bomstrong/eyebot_report/appendix01.tex

%\chapter{Source Code (Raspberry Pi)}

%\lstinputlisting[caption=main.c, language=C, label=lst_main.c]{/home/jafp/Dropbox/nfs/eyecam/main.c}
