bomstrong/eyebot_report/ch_motors.tex

\chapter{Controlling The Motors}
\label{ch:motors}

%Keywords: PWM, Encoder, H-bridge, direction control, , position controller, speed controller, straight forward controller
%duty cycle, measurements and tests, pwm frequency, h-bridge limitations
%Figures: PWM, H-bridge output (measurement), tacho (theory + measurement), schematic (section cut), direction table, 

\section {The DC-motor}

The DC-motor is an essential part of the robot. The motors used in this project are the Faulhaber 2233012S which is a 12 volt armature motor.  To succeed the tasks given in the assignment is it very important to gain control over the motor by understanding the datasheet that describes the motor. The motors dose not only supply the robot with driving force but is also the steering part of the robot.

\subsection{Gears}
To give the robot more torque a gear system has been implemented in the motors. The cost of high torque through a gear-system is a reduction in rotational speed. The gearing factor that is used is $\frac{1}{17.2}$ which means that the output shaft only turns one revolution every times the motor itself have turned 17.2 revolutions. The gear system do have some disadvantages by giving the motor nonlinearity like backlash and deadlocks. 

\subsection{Transfer function for DC-motor}
In assignment 1 from the control theory course we calculated a transfer function for at DC-motor. By using this knowledge and theory we are able to calculate a transfer function for the DC-motor used in this project.
The transfer function for the DC-motor is needed for making simulations of the hole system later on.\\
All motor data is fund in the datasheet and the weight of the robot is fund by weighting the robot on a digital precision scale and is fund to be 1400 g or 1.4 kg. \\

The general transfer function:

\begin{equation}
G(s)=\frac{\theta_m(s)}{E_a(s)} \Rightarrow \frac{\frac{k_t}{R_a J_a}}{s+\frac{1}{J_a}(D_a + \frac{K_bK_t}{R_a})}
\end{equation}
  
 The transfer function for the robot: 

\begin{equation}
G(s)=\frac{\omega(s)}{E_a(s)}=\frac{\frac{1633}{23.43}}{s\frac{1}{23.43} +1} = \frac{69.69}{0.04268+1}
\end{equation}  

Where $0.04268$ is the time constant. \\
The step respons on the DC-motor looks like this:

\begin{figure}[!h]
	\centering
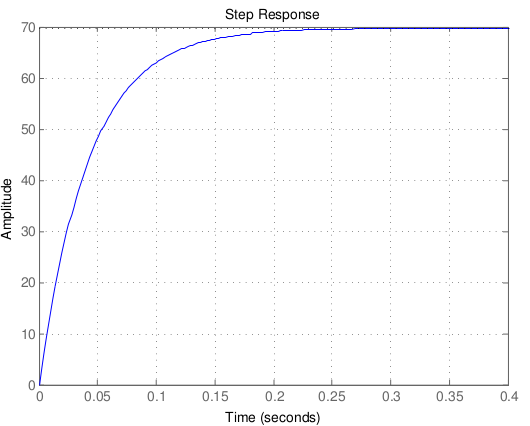
[picture p14: resources/motor_transfer_function.png]
	
	\caption{Step respons for DC-motor}
	\label{fig:2}
\end{figure}

\section{Microcontroller} 
The MCU (Microcontroller) is the first part of the link between the sensor input and the DC-motor. In the MCU a translation is made so that the DC-motor can be controlled using simple I2C (Two wire communication) commands from the Raspberry pi. A controller is also implemented in the MCU so that the robot is able to run straight without any further instructions from the Raspberry pi.\\

The MCU decodes the command form the Raspberry pi and then extracts informations about direction and speed. These informations is then send down to a H-bridge and ends as Voltage in the DC-motor.

\subsection{Atmel's XMEGA series}
The MUC used in the robot is an Atmel ATxmega192c3 a 8bit low-power microcontroller with 192kbyte flash memory running a clock frequency at 32 MHz. The choice of this MCU is based on the its speed performance and its high level of functionality features. The first MCU used in this project was a Atmel Atmega 32 but after a brief discussion in the group and with the project supervisor we decided to change the MCU to a more modern model. We previously worked with the Atmega32 and wanted to explore more recent technologies and the opportunity to work with the SMD (surface mounted device) method. 

\subsection{Programming and tools}
The MUC is programed using Atmel studio 6.1 and the program language used is C. The ASF (Atmel Software Framework, \citep{asf}) libraries has be used to a great extent.  \\
The source code for the MCU can be found in the appendix. 

\section{H-bridge as driver}
The H-bridge (TI293DNE) is a well known easy to use device. The devise have been used for robotics for many years and is well documented. \\  
The H-bridge receive three lines per motor (six in total) from the MCU the first line controls the speed with a PWM signal and the to other lines control the rotational direction of the motor. The output from the H-bridge is connected directly to the two DC-motors.

\subsection{PWM - Pulse Width Modulation}

PWM (Pules-width modulation) is a frequently used method in electronics. The signals intensity it controlled by changing the duty cycle for a square wave signal with a predefined frequency. The controllable range is from 0$\% $ to 100$\%$ 
The frequency of the square has been chosen to be 20kHz so that is it over the human hearing range. 
\\
The figures below shows how a 25$\%$ and a 50$\%$  PWM looks between the MCU and the H-bridge. The duty cycle output of the MCU is about 15 $\%$ and 82$\%$ The reason for that is that the controller in the MCU manipulates the PWM, more about this in the Control System chapter.

\begin{figure}[!h]
	\centering
	\subfloat[PWM with input at 25$\%$] {
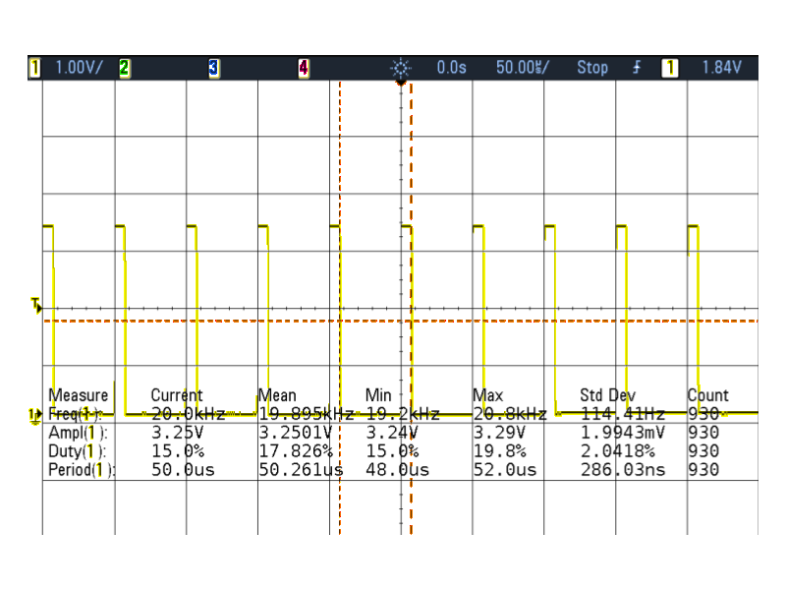
[picture p15: resources/Scop/PWM_motot_right_PWMin25.png]
		
		%\caption{PWM with input at 25$\%$}
		\label{fig:1}
	}
	\subfloat[PWM with input at 50$\%$] {
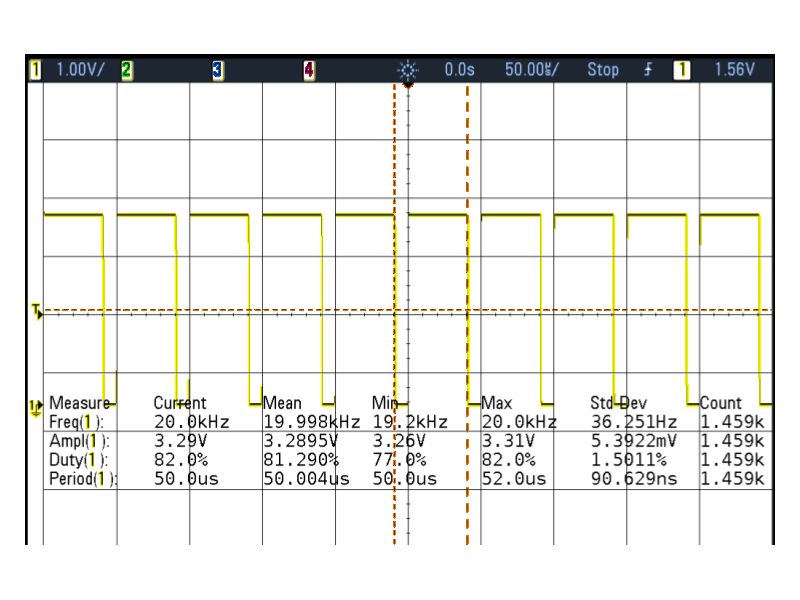
[picture p16: resources/Scop/PWM_motot_right_PWMin50.png]
		
		%\caption{PWM with input at 50$\%$}
		\label{fig:2}
	}
\end{figure}

\subsection{Direction control} 
To control the rotational direction of the DC-motor the H-bridge receives two lines A1 and A2 from the MCU.

When line A1 is high and line A2 is low the corresponding switches S1 and S4 is closed so that the current is running in one direction. when A1 is low and A2 is high the current is running the other way and the motor it turning the other way around. \\
  \begin{figure}[!h!]
	\centering
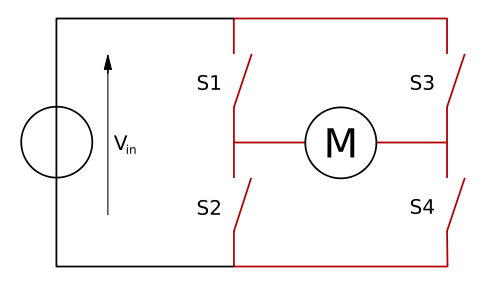
[picture p17: resources/H-bridge_diagram.png]
	
	\caption{H-bridge}
	\label{fig:3}
\end{figure}

  \begin{figure}[!h!]
	\centering
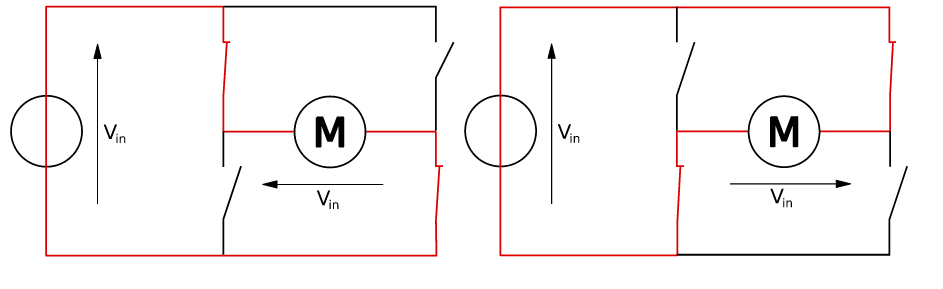
[picture p18: resources/h_bridge_2.png]
	
	\caption{H-bridge in the two states}
	\label{fig:3}
\end{figure}

In figure 3.6 is a truth table that describes the functionality of the H-bridge. The EN pin is the PWM input.  

  \begin{figure}[!h!]
	\centering
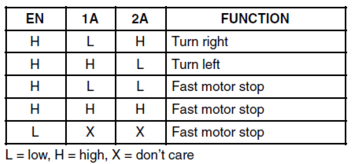
[picture p19: resources/H-bridge_table.png]
	
	\caption{H-bridge truth table}
	\label{fig:intro_4}
\end{figure}

\section{Encoders}
  The DC-motor includes two encoder outputs which is used to determine position, velocity and direction of the DC-motor.
  Each encoder outputs 15 pulses per round and after the gears is the resolution $15 \cdot 17.2 = 258$ pulses per round.
  The two encoder signals is phase shifted at about $\ang{90}$ and that gives us the opportunity to determine the rotational direction of the motor by looking at one encoder signal and then check if the other one it high or low. This method is illustrated below in figure 3.7.
   
  \begin{figure}[!h!]
	\centering
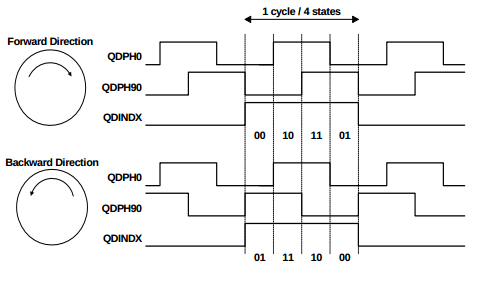
[picture p20: resources/encoder_atmel.png]
	
	\caption{Encoder illustration (from Atmel's Application Note on Quadrature Decoders, \citep{avr1600})}
	\label{fig:5}
\end{figure}

Figure 3.8 shows the actual encoder output from the robot. The phase is about $\ang{100}$ between the two encoders.
  \begin{figure}[!h!]
	\centering
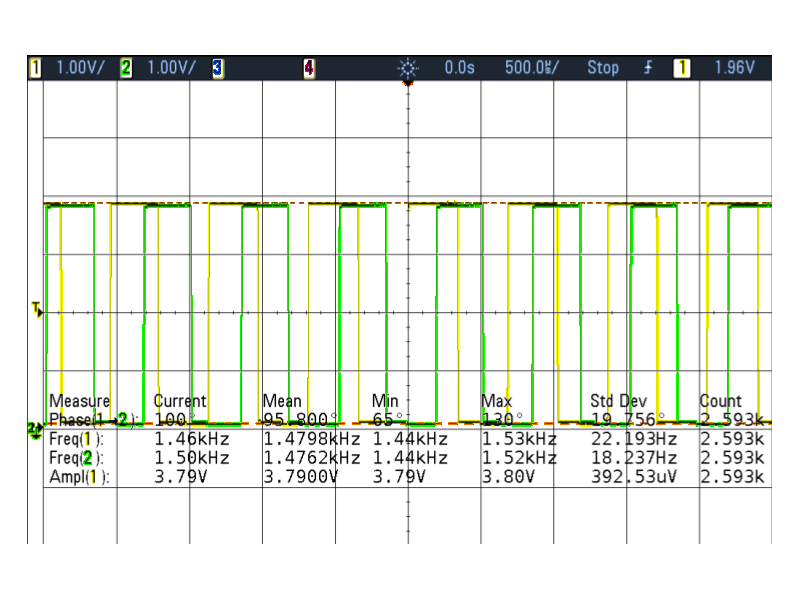
[picture p21: resources/Scop/encoder.png]
	
	\caption{Encoder output from Motor to MCU}
	\label{fig:6}
\end{figure}
%-----------------------------------------------------_SKAL RETTES _-----------------------------------------
The velocity is found by sampling the encoder pulses over a time period of 10ms, by counting the pulses during this time and multiply it with a constant the velocity of the motor is given.
Also the position between the two motors can be find by using two encoders on each motor. First we look at one motor encoder count and then match this up the other motor so that the encoder count from the to motors fits, then we know the exact position of the robot. We use these method in the position controller.    
%skal rettes---------------------------------------------------------------------------------------------------

\section{Feedback and Control Loop}
The control loop containing the motor,MCU and encoder can be described as a unity feedback loop.

  \begin{figure}[!h!]
	\centering
	
	\caption{Unity feedback loop}
	\label{fig:6}
\end{figure}

The MCU have three different stats with three different controllers so that it can adapt to the given situation during the track. The three states are:

\begin{itemize}
	\begin{item}
		\textbf{Straight}\\ This state is designed to make the robot go straight without any corrections from the Raspberry Pi. This it done by given both motors a reference speed and then aligning them after the outputs from the encoders by adjusting the speed to each motor. 
	\end{item}
	
	\begin{item}
		\textbf{Position}\\This state is used when the robot has to do precision maneuvers. 
	\end{item}
	
	\begin{item}
		\textbf{Speed}\\This state is used when the robot follows the line by adjusting after instruction from the Raspberry Pi.
	\end{item}

\end{itemize}

The selection of which current stat the MCU should be in is determinant by the raspberry pi and is set through the I$^2$C bus.
The different controllers from the three states can be found in the control system chapter.
