bomstrong/eyebot_report/eyebot_jp.tex

% Master Thesis DTU Template
% Remus M. Prunescu remusmp@gmail.com Feb, 2011

\documentclass[a4paper,11pt]{memoir}

% Include all settings
\input{setup}

\begin{document}

\input{titlePage}
\input{images}

\frontmatter
\tableofcontents
\cleardoublepage
\listoffigures
\printnomenclature

\mainmatter

\input{ch_intro}
\input{ch_camera}
\input{ch_motors}
\input{ch_wall_dist}
\input{ch_communication}
\input{ch_controller}
\input{ch_track}
\input{ch_simu}
\input{ch_conclusion}

\appendix
%\appendixpage

\input{appendix01}
%\input{appendix02}
%\input{appendix03}

\backmatter

\bibliography{references}
\bibliographystyle{plainnat}

% For biblatex
%\printbibliography
%\printindex

\end{document}
