bomstrong/eyebot_report/titlePage.tex

\begin{titlingpage}
 \thispagestyle{empty}
 \enlargethispage{1.3cm}
 \calccentering{\unitlength}
 \begin{adjustwidth}{\unitlength}{-\unitlength}
 %\begin{raggedleft}
  \vspace*{-1.9cm}
  %\hspace{8cm}\includegraphics[width=0.5\textwidth]{resources/tex_dtu_uk_a1_cmyk}\\[1cm]
  \begin{textblock}{6.5}(5.5,0) %
   
  \end{textblock}
 %\end{raggedleft}
  \begin{raggedright}
   \vspace{\stretch{1}}
   %\vspace{1cm}
   {\Huge\sffamily\ThAuthors\\[2cm]}
   \begin{Spacing}{1.2}
    {\sffamily\HUGE\textbf{\ThTitleEN}\\[1.5cm]}
    %{\sffamily\LARGE\textbf{{\ThSubtitleEN}}\\[1cm]}
    {\sffamily\LARGE{4th Semester Project in Control Theory}\\[2cm]}
   \end{Spacing}
   \vspace{\stretch{1}}
   %\begin{Spacing}{1.5}
   %{\Large Supervisors:\\}
   %{\Large\ThSupervisors\\}
   %\end{Spacing}
   %\vspace{\stretch{3}}   
   %{\sffamily DTU - Technical University of Denmark, Kgs. Lyngby - 2011}\\[1cm]
   %\vspace{\stretch{4}}
 \end{raggedright}
 %\begin{raggedright}
 %  \includegraphics[width=0.5\textwidth]{resources/tex_dtu_elektro_a_uk}%
 %  \ifthenelse{\equal{\bCompanyLogo}{true}}{%
 %   \begin{textblock}{3}(9.5,-0.85) %
 %    \includegraphics[width=\textwidth]{resources/CompanyLogo}
 %   \end{textblock}
 %  }{} % End if
 %\end{raggedright}

 \end{adjustwidth}
 
 \clearpage
 
 %\thispagestyle{empty}
 %\enlargethispage{1.3cm}
 %\calccentering{\unitlength}
 %\begin{adjustwidth}{\unitlength-0.4cm}{-\unitlength-0.4cm}
 %\begin{raggedleft}
 % %\vspace*{-2.5cm}
 % %\includegraphics[width=0.5\textwidth]{resources/tex_dtu_uk_a1_cmyk}\\[1cm]
 %%\end{raggedleft}
 % \begin{center}
 %  \vspace{\stretch{1}}
 %  %{\sffamily\Huge Author:}\\
 %  \vspace{1.5cm}
 %  {\Huge\scshape\ThAuthors}\\[2cm]
 %  \begin{Spacing}{3}
 %   {\sffamily\HUGE\textbf{\ThTitleEN}}\\[1cm]
 %   {\sffamily\LARGE\textbf{{\ThSubtitleEN}}}\\[1cm]
 %  %{\sffamily\LARGE\textbf{\color{red}CONFIDENTIAL\\BURN AFTER READING}}\\
 %  %\vspace{\stretch{3}}
 %   {\sffamily\LARGE{Master's Thesis, September 2011}}\\[2cm]
 %  \end{Spacing}
 %  \vspace{\stretch{2}}
 %  \begin{Spacing}{1.5}
 %  {\Large Supervisors:}\\
 %  {\Large\ThSupervisors\\}
 %  \end{Spacing}
 %  \vspace{\stretch{3}}   
 %  {\sffamily DTU - Technical University of Denmark, Kgs. Lyngby - 2011}\\[1cm]
 %  \vspace{\stretch{4}}
 %\end{center}
 %\begin{raggedright}
   %\includegraphics[width=1.4cm]{resources/DTULogo.pdf}\\[1cm]
   %{\raggedright\includegraphics[width=0.5\textwidth]{resources/tex_dtu_elektro_a_uk}}
 %\end{raggedright}
  
 %\end{adjustwidth}
 
 %\cleardoublepage
 
\thispagestyle{empty}
 \calccentering{\unitlength}
 \begin{adjustwidth*}{\unitlength}{-\unitlength}
  %\vspace{\stretch{1}}
  %\textbf{\ThTitleEN, \ThSubtitleEN}\\
  \textbf{\ThTitleEN}
  %\textbf{\ThTitleDK, \ThSubtitleDK}
  \vspace{\stretch{1}}

  \noindent\textbf{This report was prepared by:}\\
  \ThAuthors
  
  \vspace{\stretch{2}}

  \noindent\textbf{Advisors:}\\
  \ThSupervisors
  
  \vspace{\stretch{3}}

  \noindent\ThDepartment
  
  \vspace{\stretch{4}}
  
  \noindent\ThElektroEmail
  
  \vspace{\stretch{5}}
  
  \noindent{\renewcommand{\arraystretch}{2}\begin{tabular}{@{}lp{0.75\textwidth}}
   Project period:&	\ThProjectPeriod\\
   ECTS:&		\ThECTS\\
   Education:&		\ThEducation\\
   Field:&		\ThField\\
   %Class:&		\ThClass\\
   %Remarks:&		\ThRemarks\\
   Copyrights:&		\ThCopyrights
  \end{tabular}}

  %\vspace{\stretch{2}}
  %\begin{center}
  % \includegraphics[width=0.8\textwidth]{resources/tex_dtu_frise.pdf}
  %\end{center}
 \end{adjustwidth*}
\end{titlingpage}
