bomstrong/eyebot_report/images.tex

  

\begin{figure}
	\centering
	\subfloat {
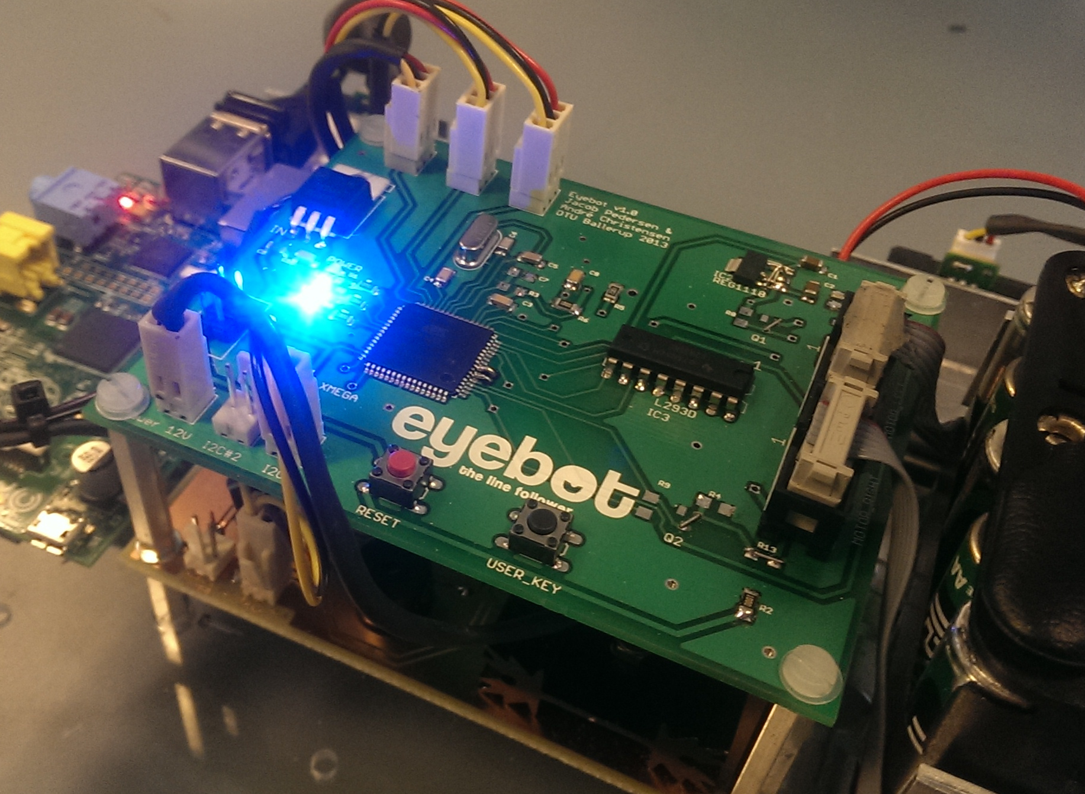
[picture p42: resources/eyebot.jpg]
		
	}
	\subfloat {
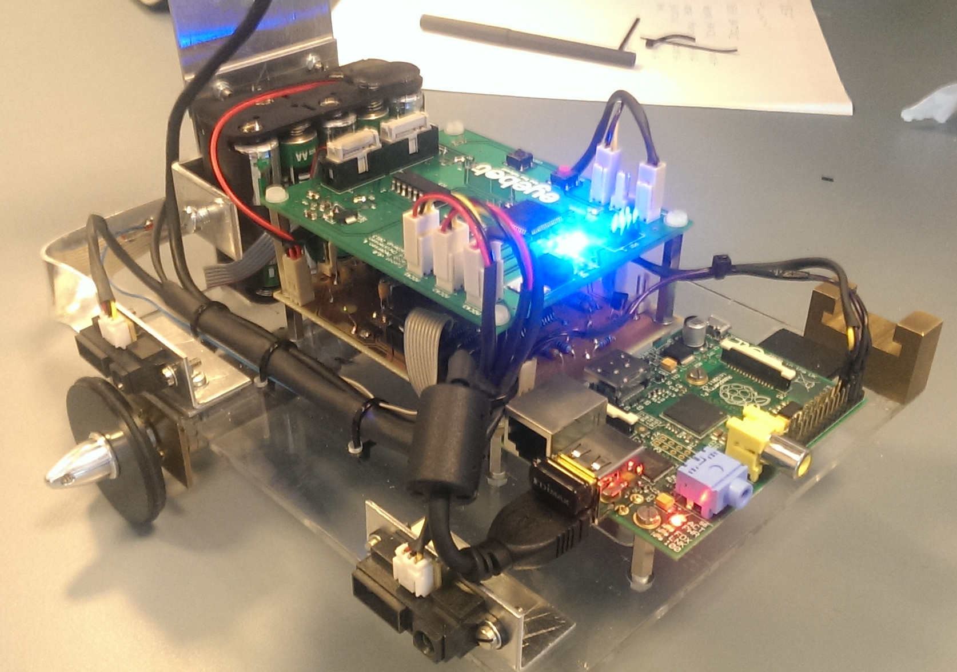
[picture p43: resources/eyebot2.jpg]
		
	}
\end{figure}

\begin{figure}
	\centering
	\subfloat {
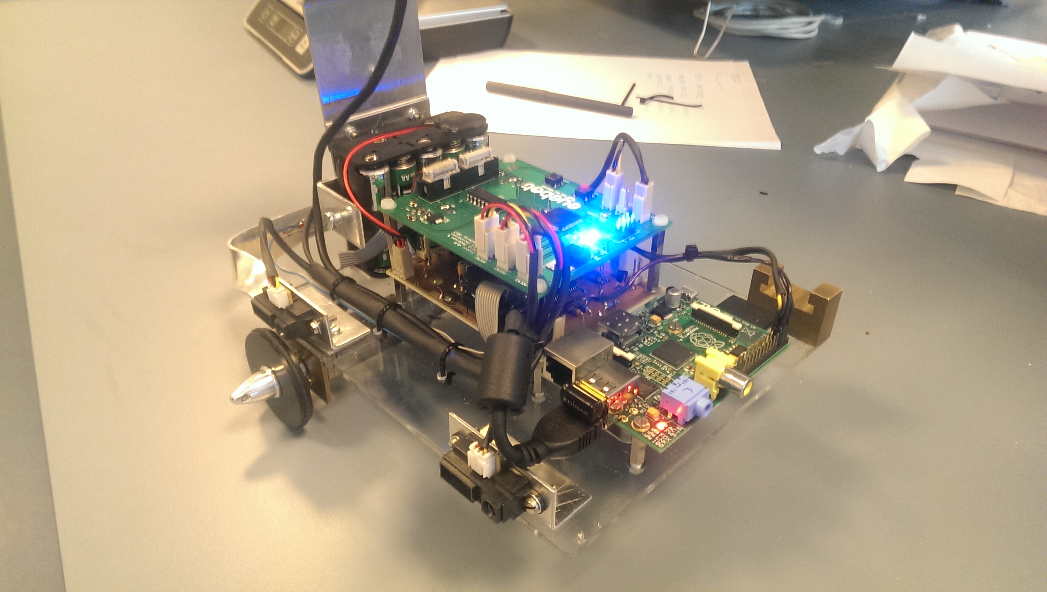
[picture p44: resources/eyebot3.jpg]
		
	}
	\subfloat {
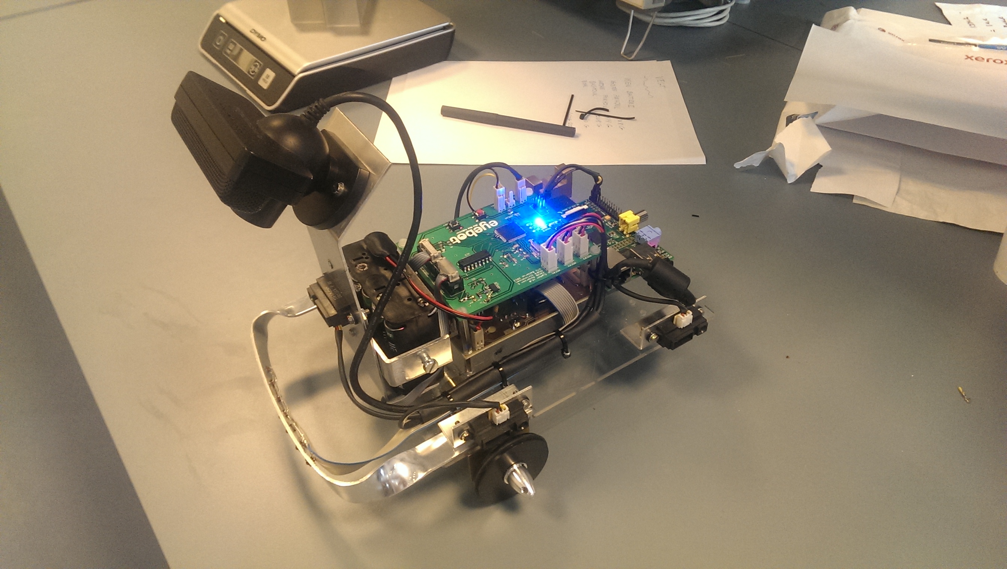
[picture p45: resources/eyebot4.jpg]
		
	}
\end{figure}

\begin{figure}
	\centering
	\subfloat {
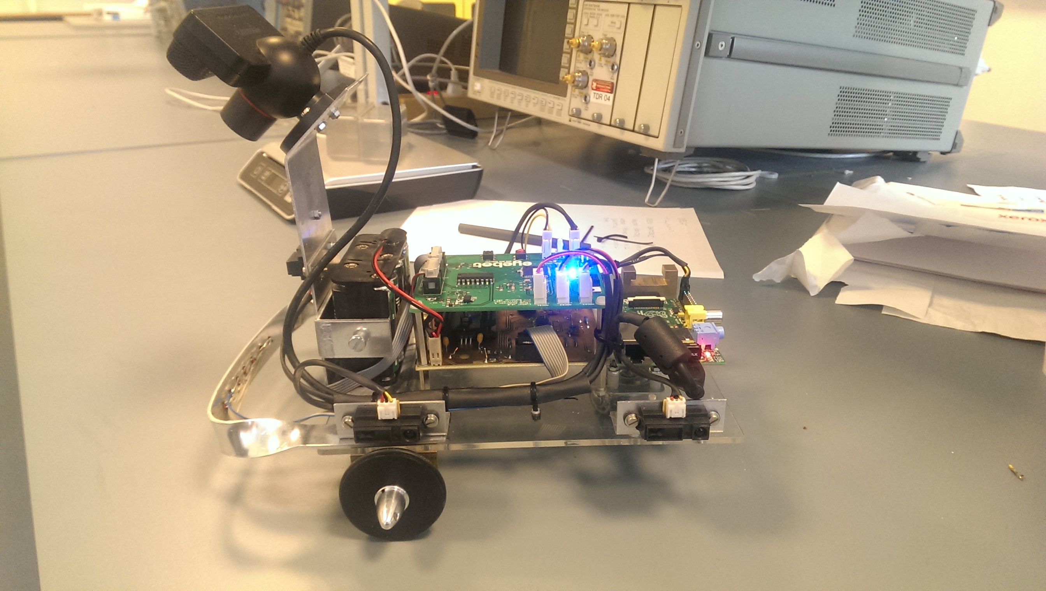
[picture p46: resources/eyebot5.jpg]
		
	}
	\subfloat {
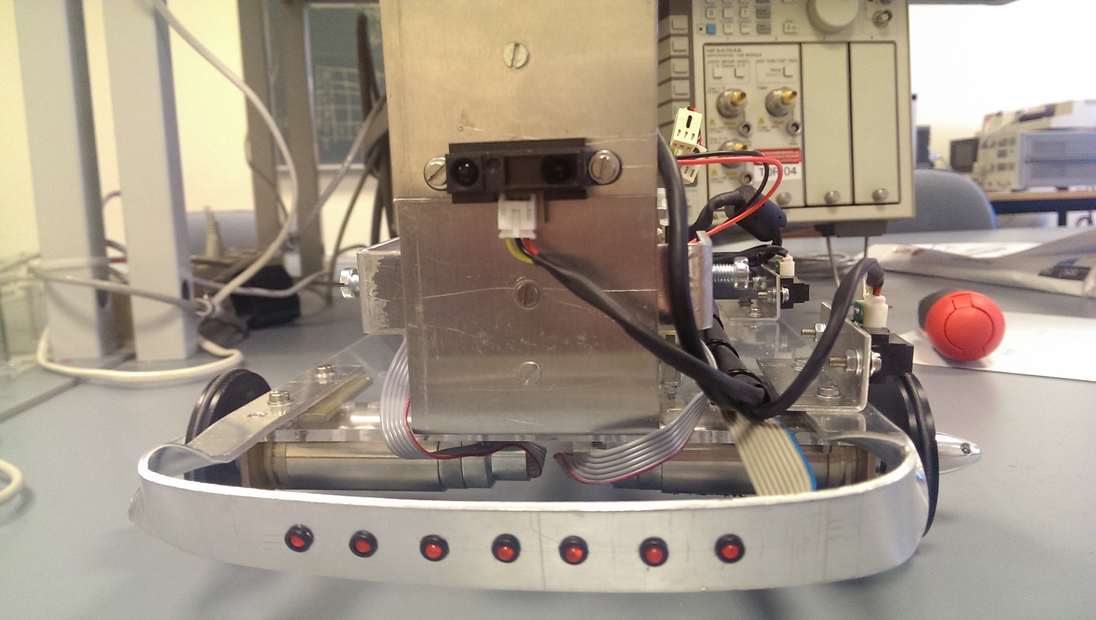
[picture p47: resources/eyebot6.jpg]
		
	}
\end{figure}

\begin{figure}
	\centering
	\subfloat {
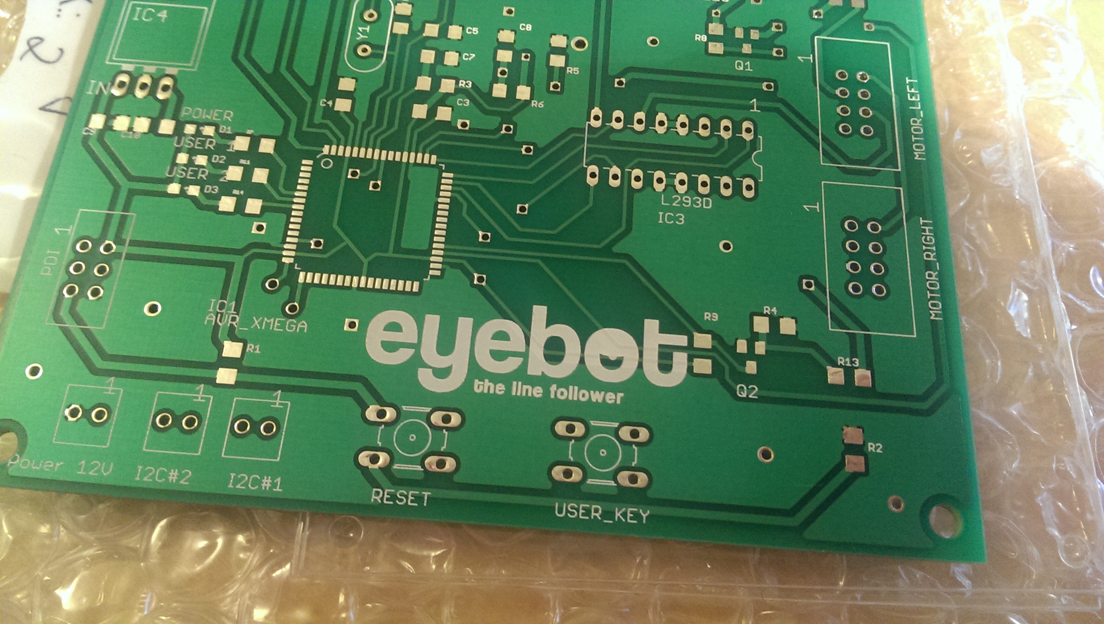
[picture p48: resources/eyebot7.jpg]
		
	}
	\subfloat {
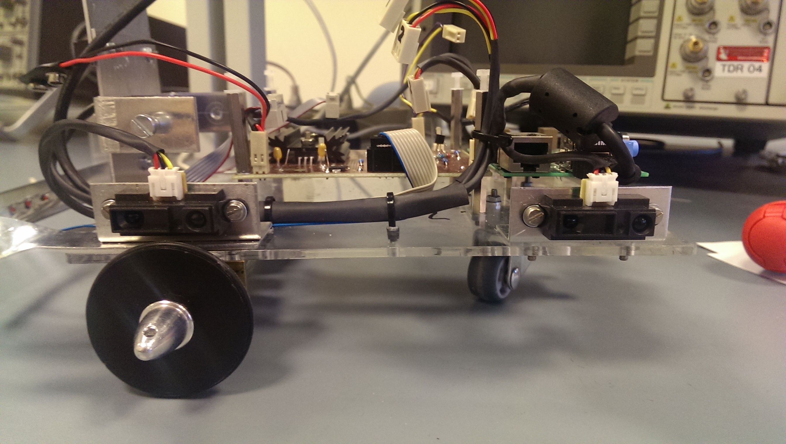
[picture p49: resources/eyebot8.jpg]
		
	}
\end{figure}
