bomstrong/eyebot_report/resources/Scop/encoder_motor_left_PWM_afterPID_14.pdf

12/12/13 | LXI - Agilent - DSO7014A - MY49110205

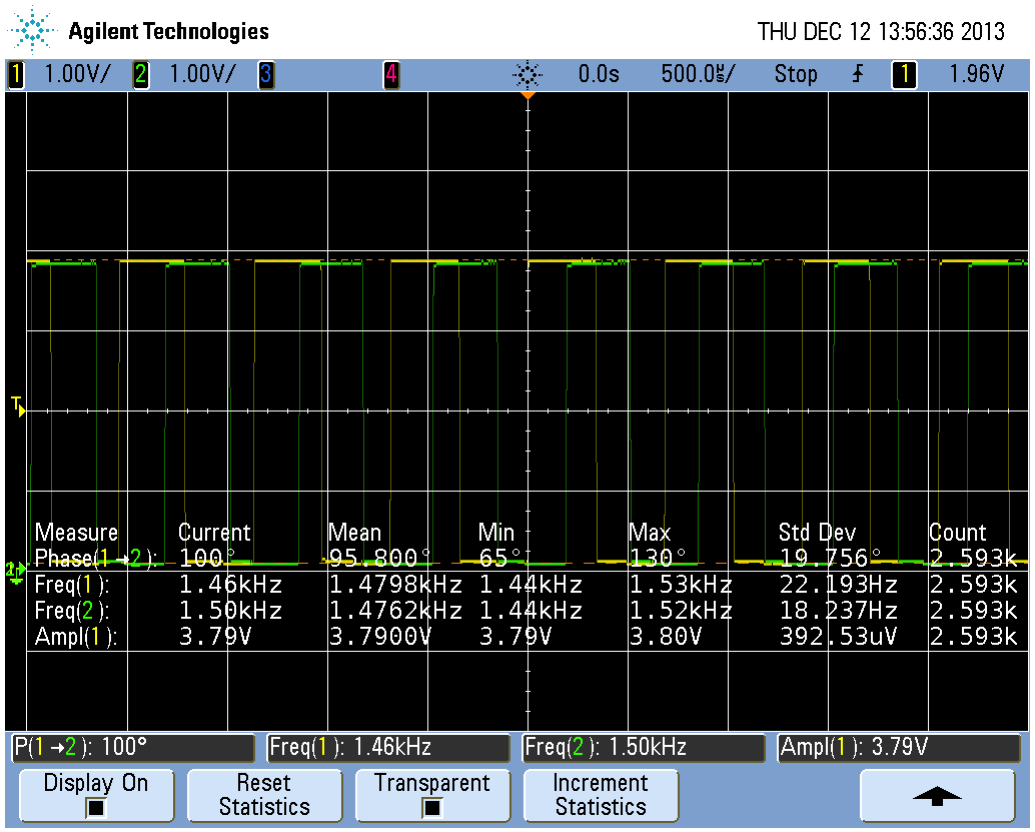
[picture p50: figure]

10.42.0.17 | 1/1

Instrument screen image uploaded 12/12/2013 2:18:25 PM
