bomstrong/eyebot_report/resources/Scop/PWM_motot_left_PWMin25.pdf

12/12/13 | LXI - Agilent - DSO7014A - MY49110205

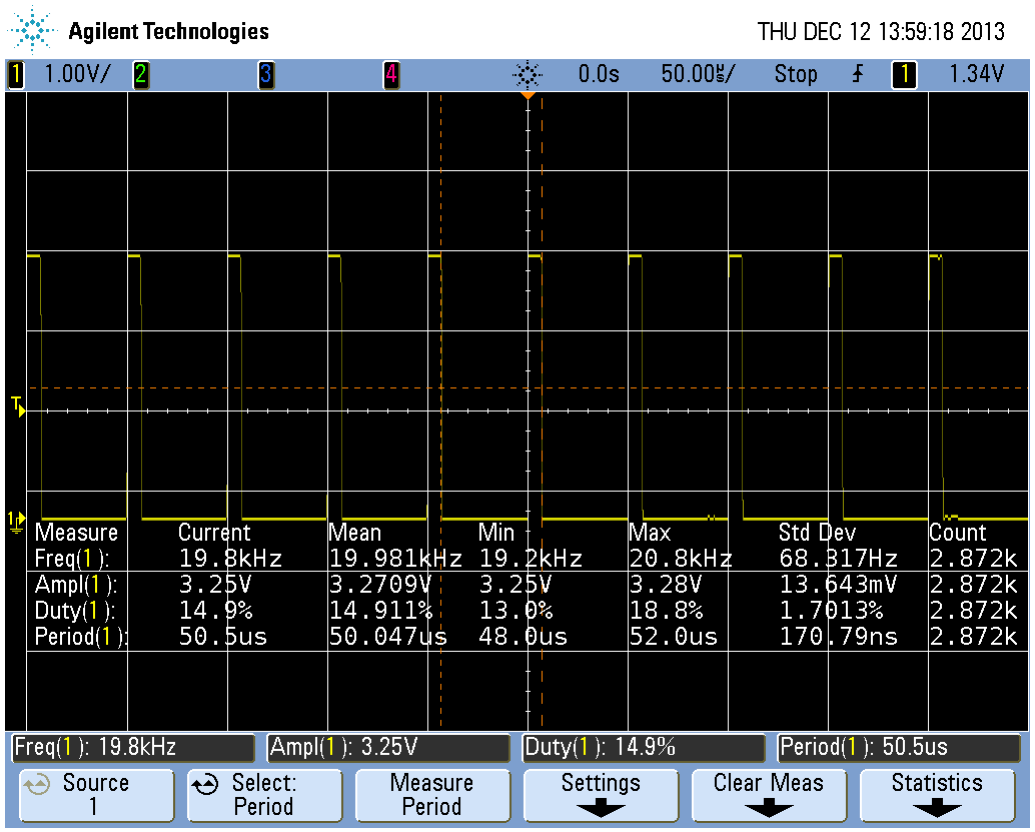
[picture p53: figure]

10.42.0.17 | 1/1

Instrument screen image uploaded 12/12/2013 2:21:07 PM
