bomstrong/eyebot_report/resources/hist-zoom.png

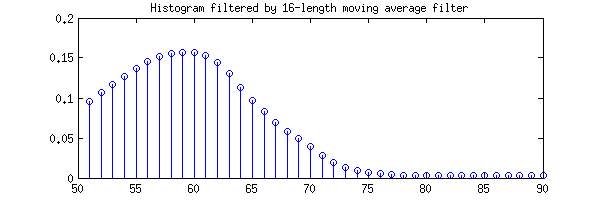
resources/hist-zoom.png
