bomstrong/eyebot_report/resources/img-raw-captures.png

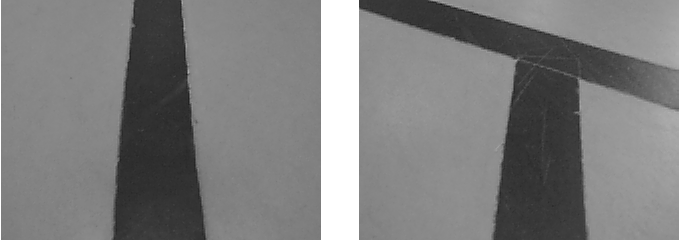
resources/img-raw-captures.png
