bomstrong/eyebot_report/resources/PCB/xmeag_motorcontroller_after_updates/PCB1.png

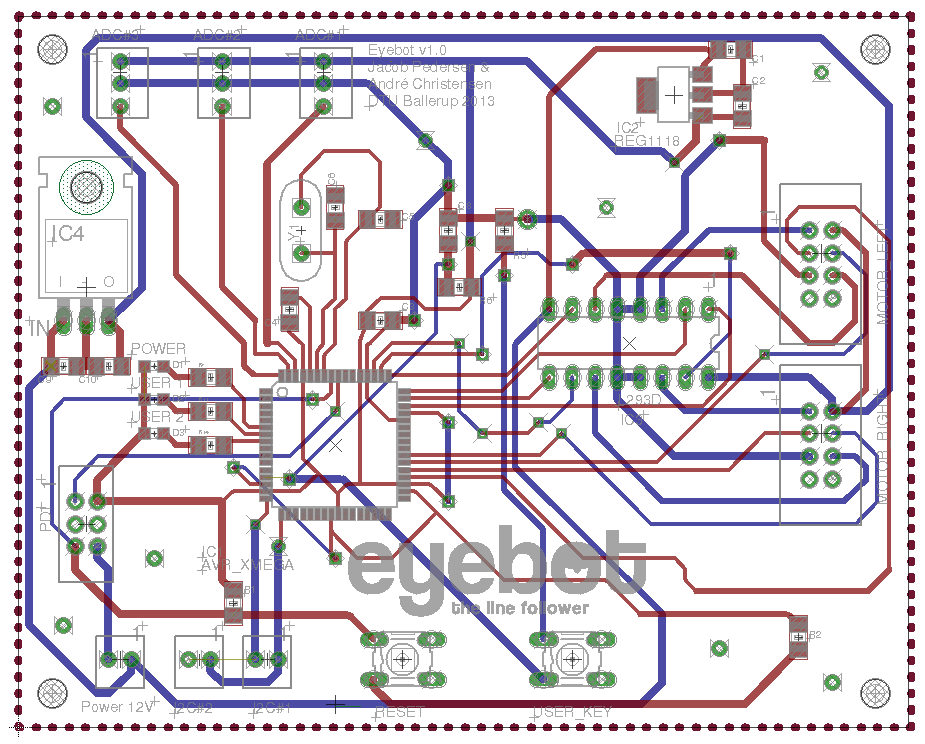
resources/PCB/xmeag_motorcontroller_after_updates/PCB1.png
