bomstrong/eyebot_report/resources/Simulink/ch_simu_2.png

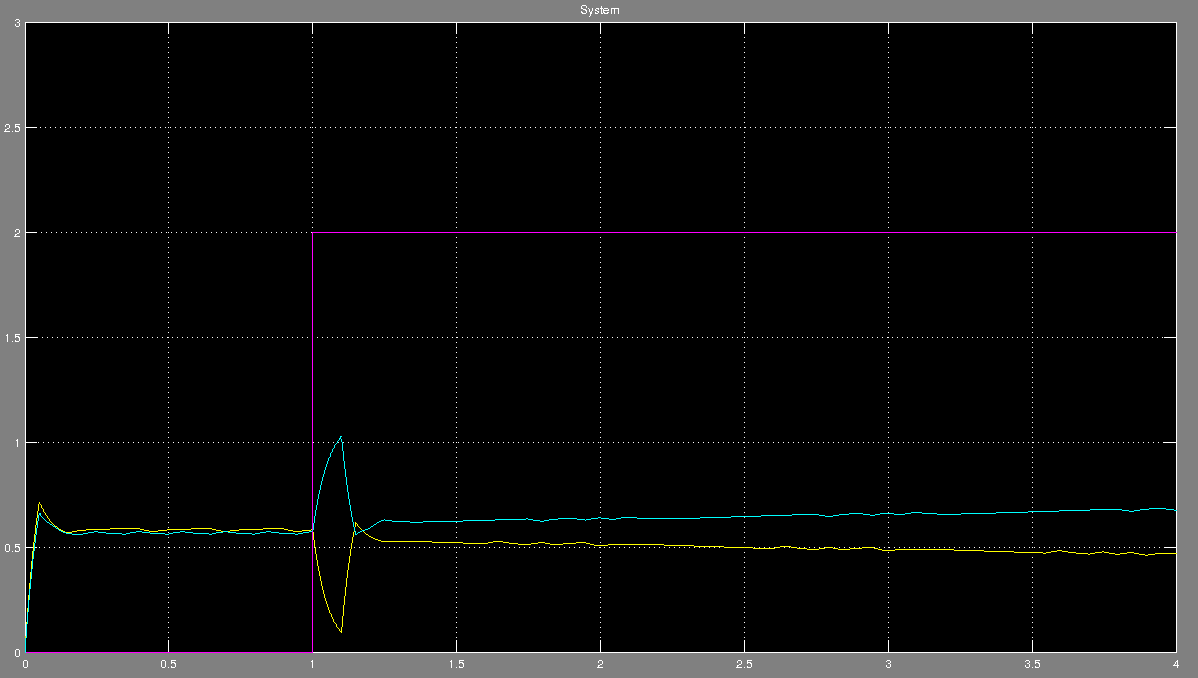
resources/Simulink/ch_simu_2.png
