bomstrong/eyebot_report/resources/Simulink/ch_simu_10.png

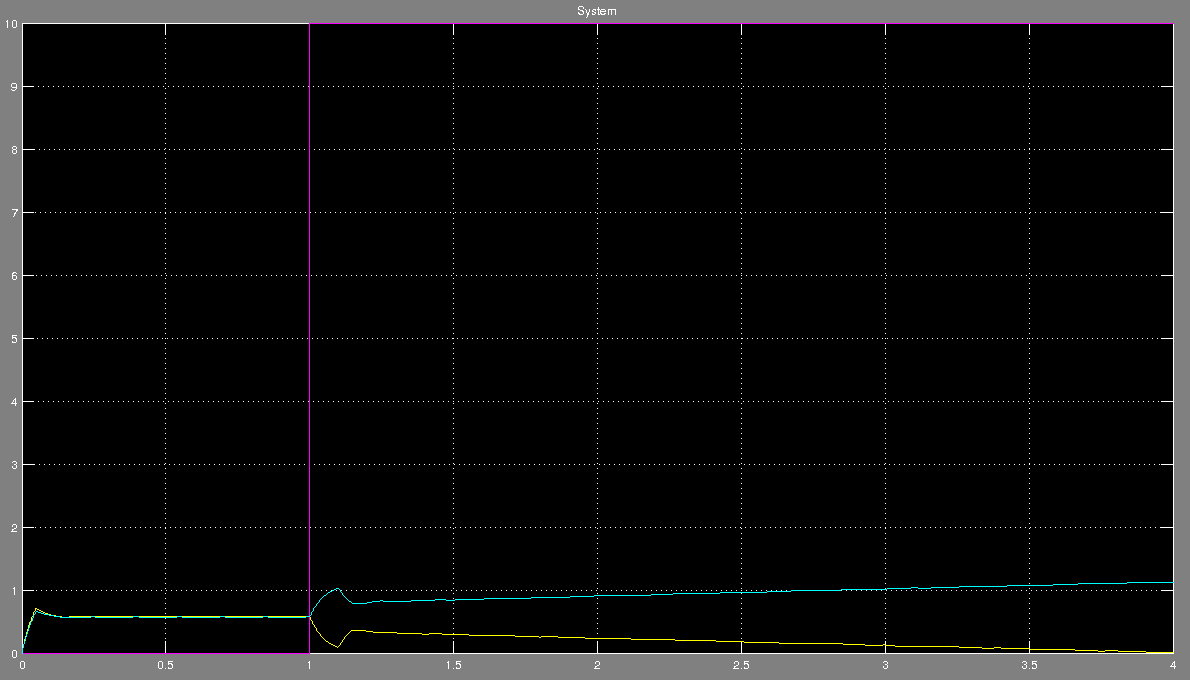
resources/Simulink/ch_simu_10.png
