bomstrong/eyebot_report/resources/Simulink/ch_simu_simulink.png

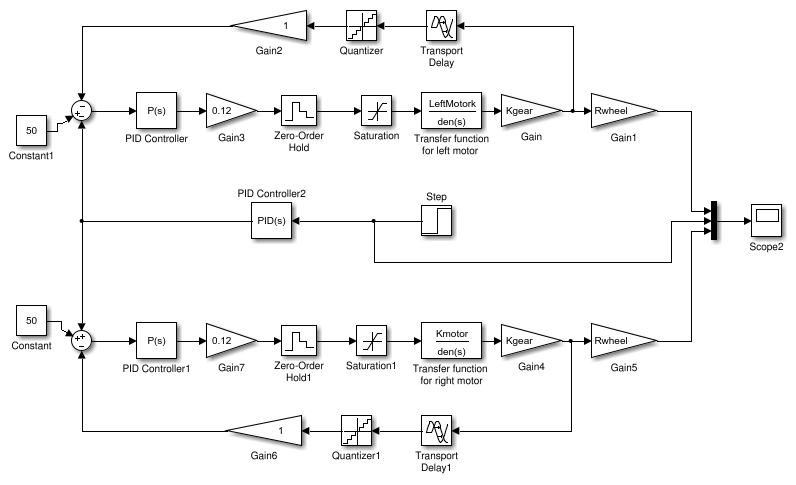
resources/Simulink/ch_simu_simulink.png
