bomstrong/eyebot_report/resources/wall_sensor.png

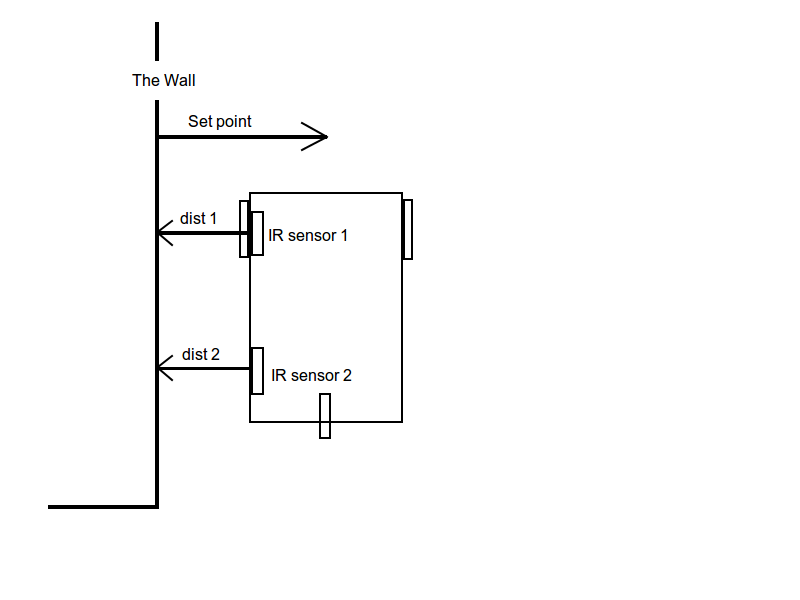
resources/wall_sensor.png
