bomstrong/eyebot_report/resources/PCB/PDF to print/Motorcontroller_sch.pdf

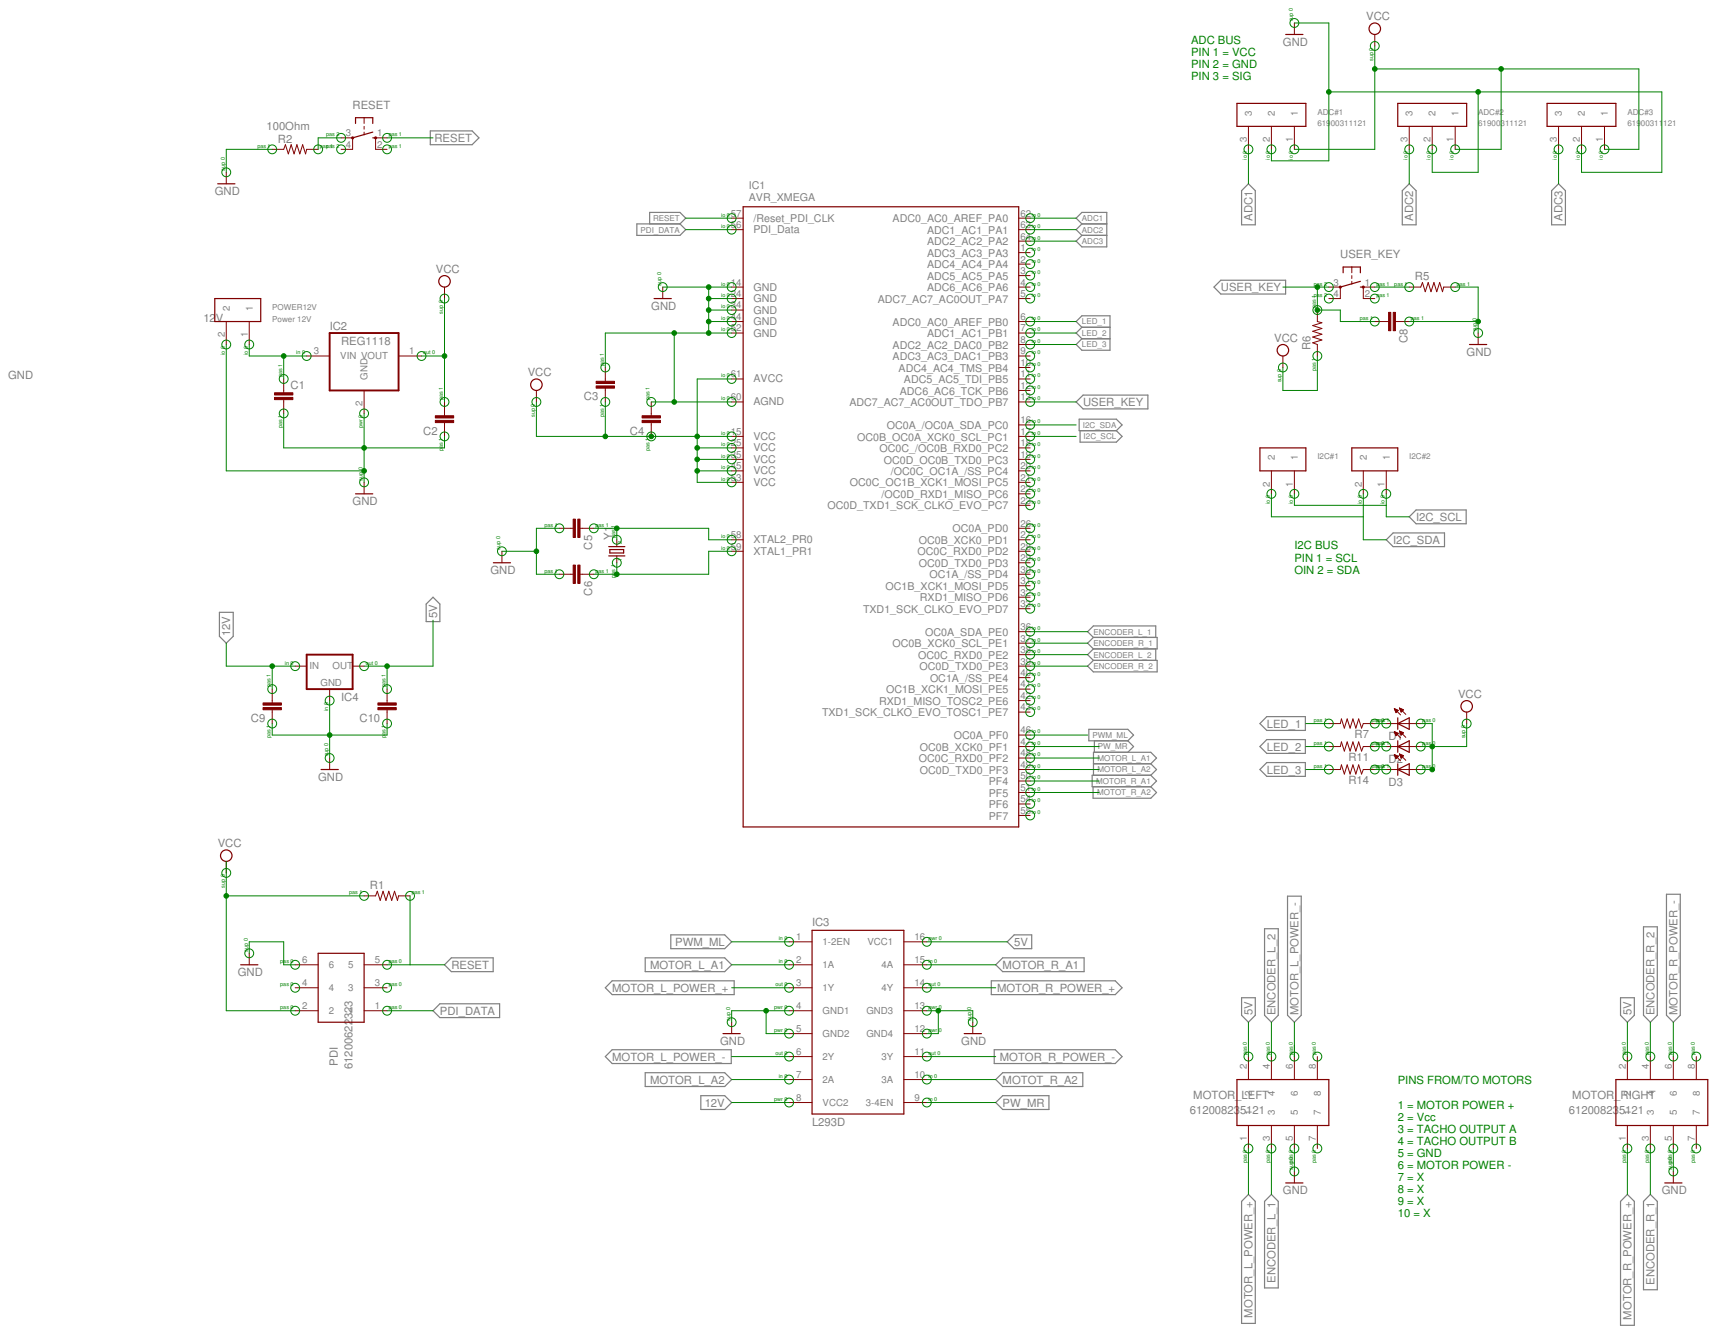
[picture p65: page 1]

35 io 0 | 19
io 0 45 | 20
53 io 0 | 21

PINS FROM/TO MOTORS
1 = MOTOR POWER +
2 = Vcc 3 = TACHO OUTPUT A
4 = TACHO OUTPUT B
