bomstrong/eyebot_report/resources/PCB/PDF to print/Motorcontroller.pdf

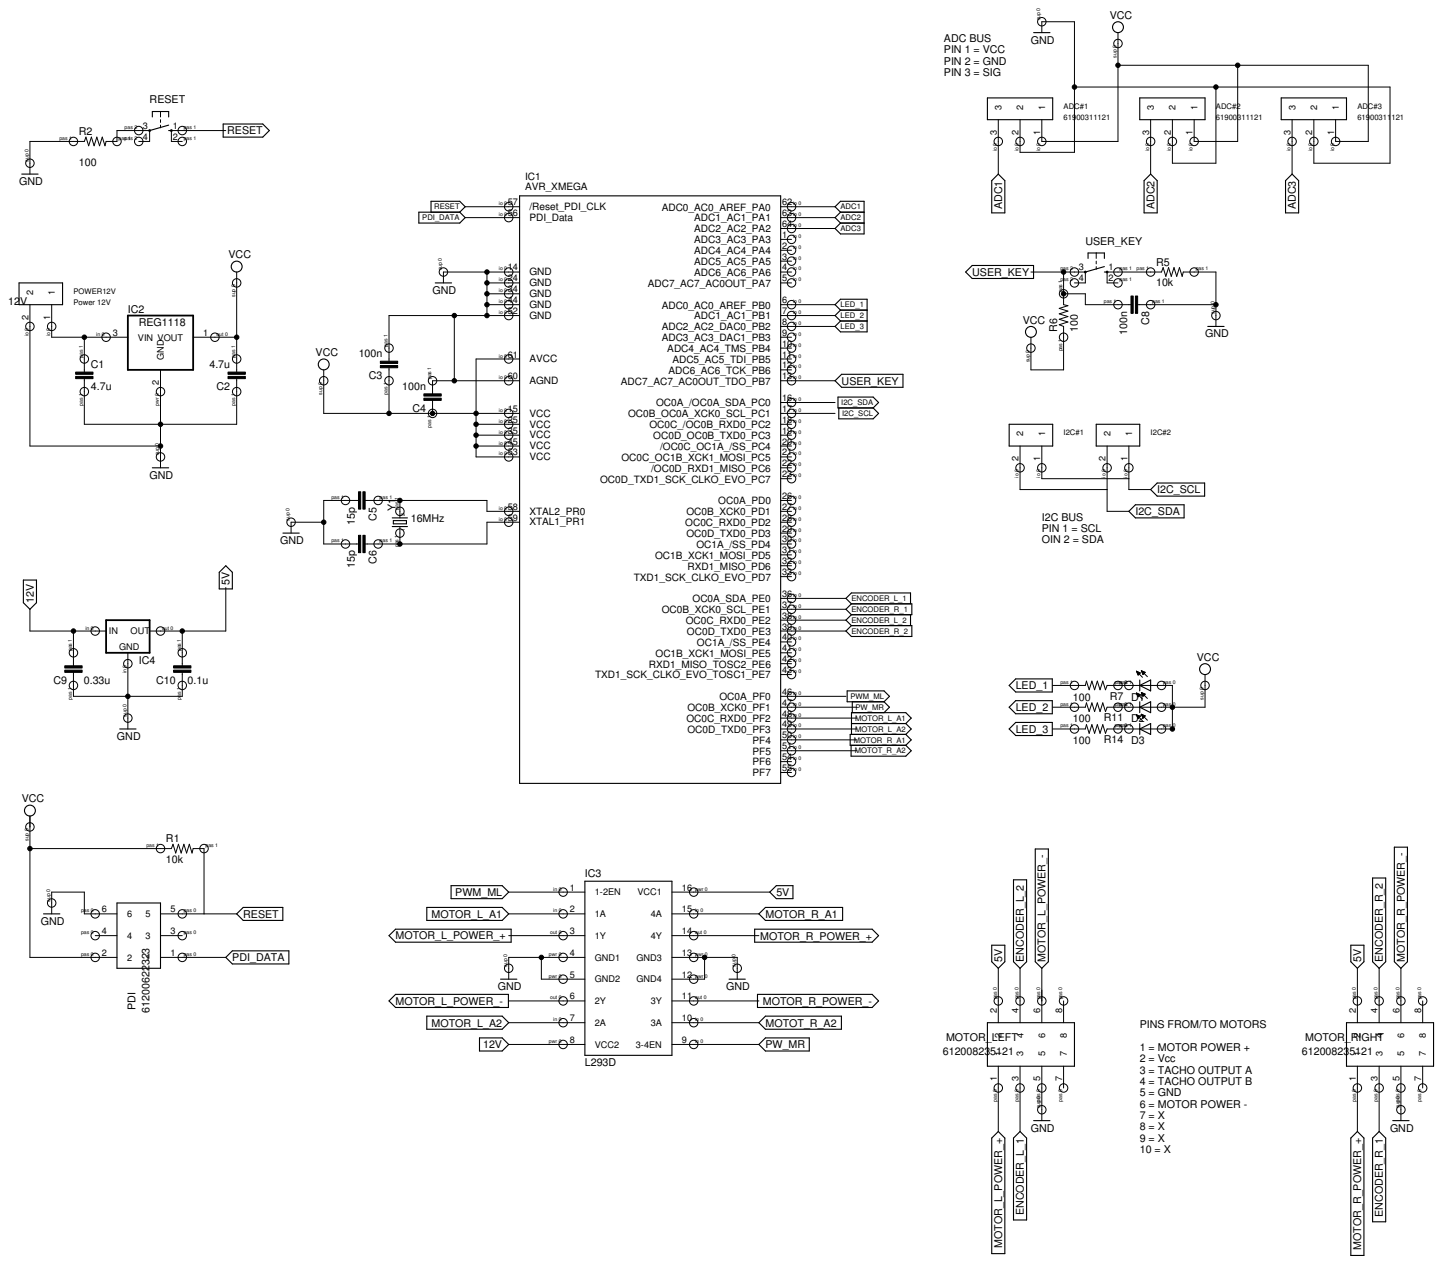
[picture p66: page 1]

25 io 0 | 18
io 0 35 | 19
45 io 0 | 20
53 io 0 | 21

PINS FROM/TO MOTORS
1 = MOTOR POWER +
2 = Vcc 3 = TACHO OUTPUT A
4 = TACHO OUTPUT B
5 = GND
