bomstrong/eyebot_report/resources/PCB/Eyebot_powerdist/Eyebot_powerdist.pdf

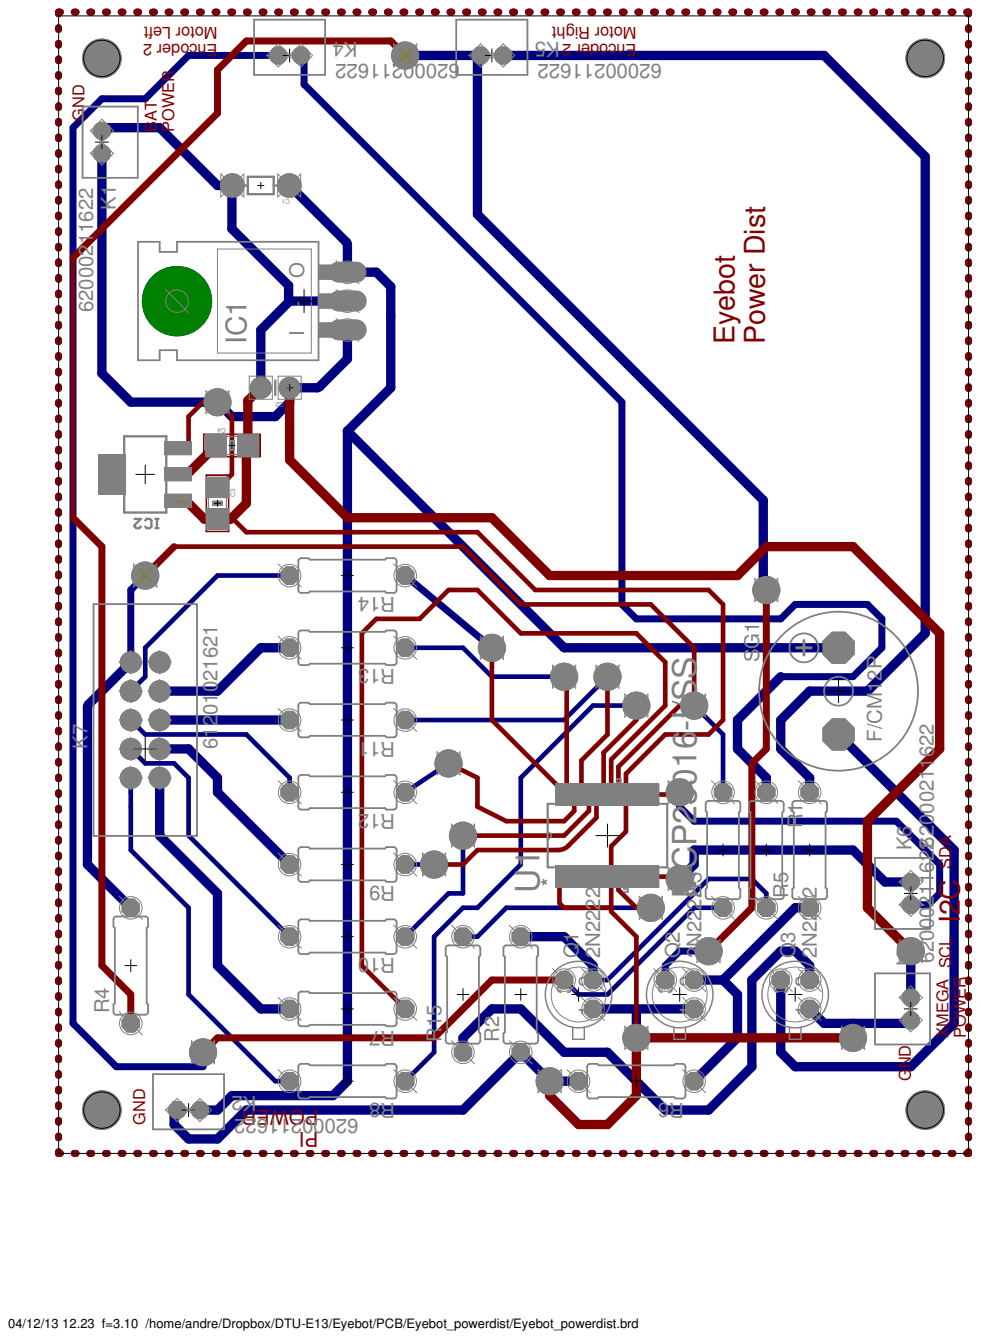
[picture p67: page 1]

04/12/13 12.23 f=3.10 /home/andre/Dropbox/DTU-E13/Eyebot/PCB/Eyebot_powerdist/Eyebot_powerdist.brd
