bomstrong/eyebot_report/resources/PCB/Eyebot_powerdist/Eyebot_powerdist_with_full_layer.pdf

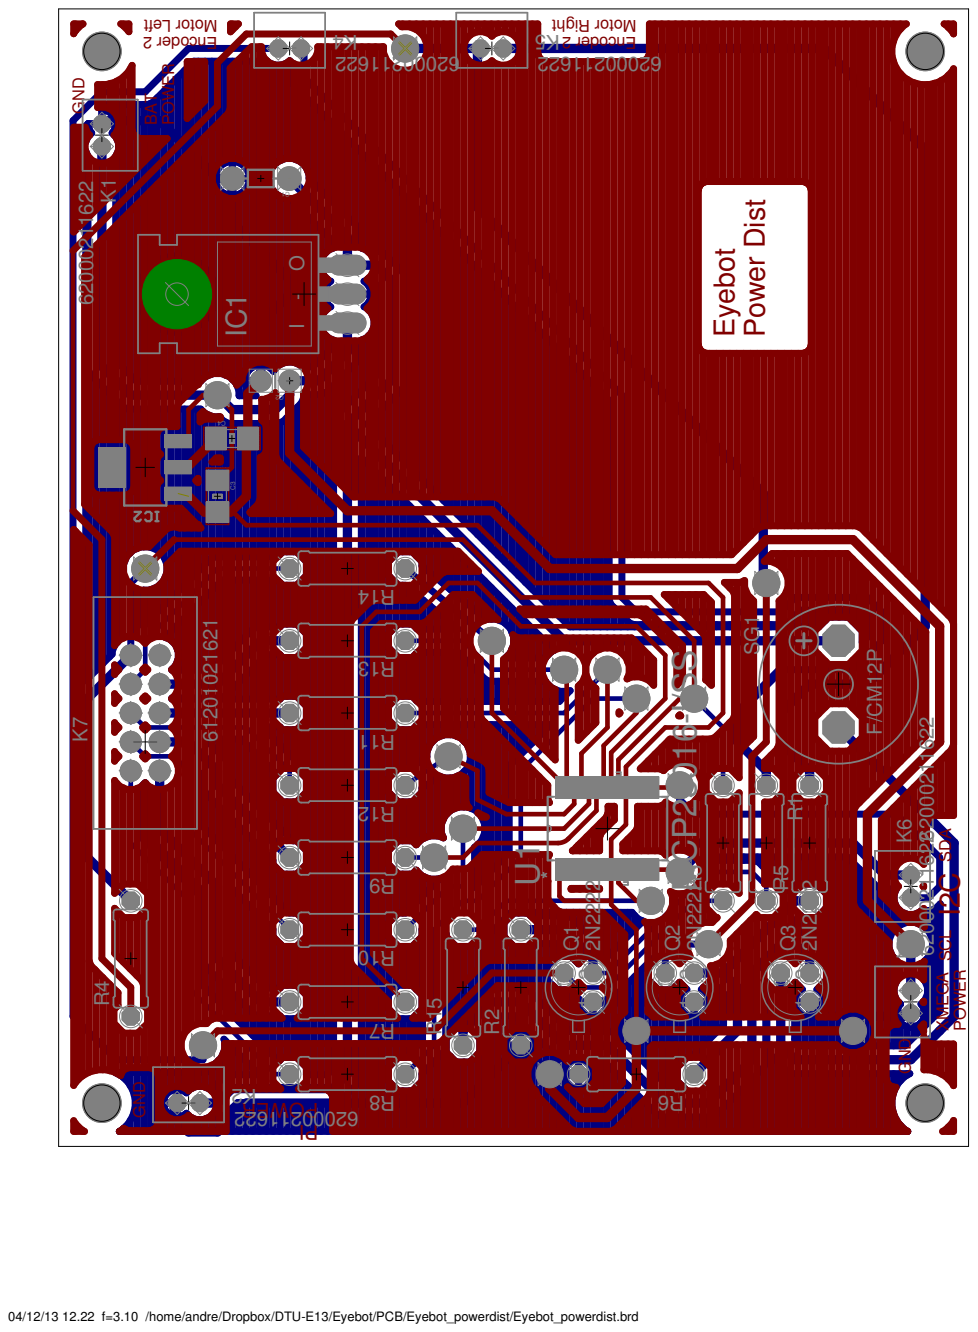
[picture p68: page 1]

04/12/13 12.22 f=3.10 /home/andre/Dropbox/DTU-E13/Eyebot/PCB/Eyebot_powerdist/Eyebot_powerdist.brd
