bomstrong/eyebot_report/resources/PCB/xmeag_motorcontroller_after_updates/Motorcontroller_pcb.pdf

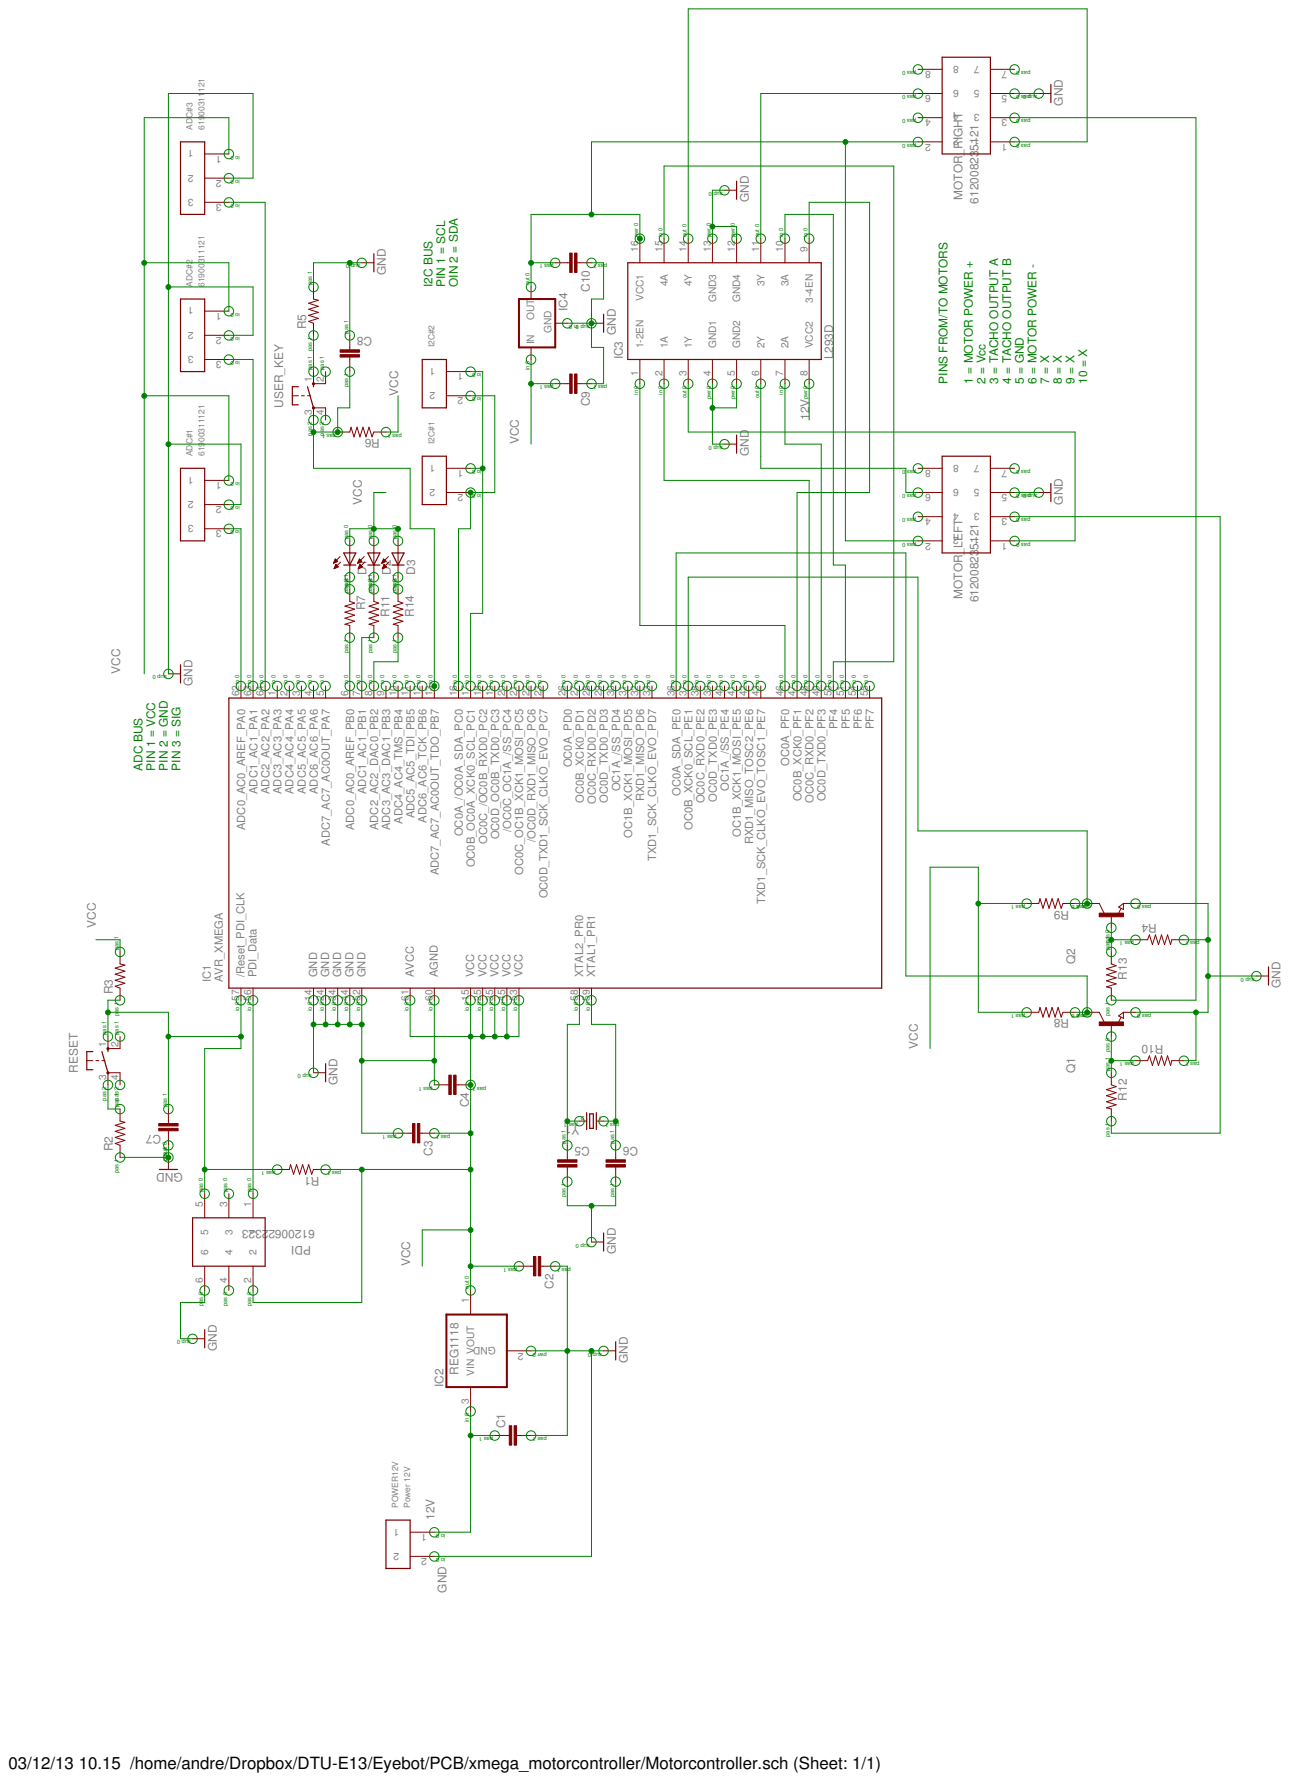
[picture p69: page 1]

PIN 1 = SCL OIN 2 = SDA

/Reset_PDI_CLK GND GND GND GND GND

pas 1 pas 1

03/12/13 10.15 /home/andre/Dropbox/DTU-E13/Eyebot/PCB/xmega_motorcontroller/Motorcontroller.sch (Sheet: 1/1)
