bomstrong/eyebot_report/resources/PCB/xmeag_motorcontroller_after_updates/Motorcontroller_sh.pdf

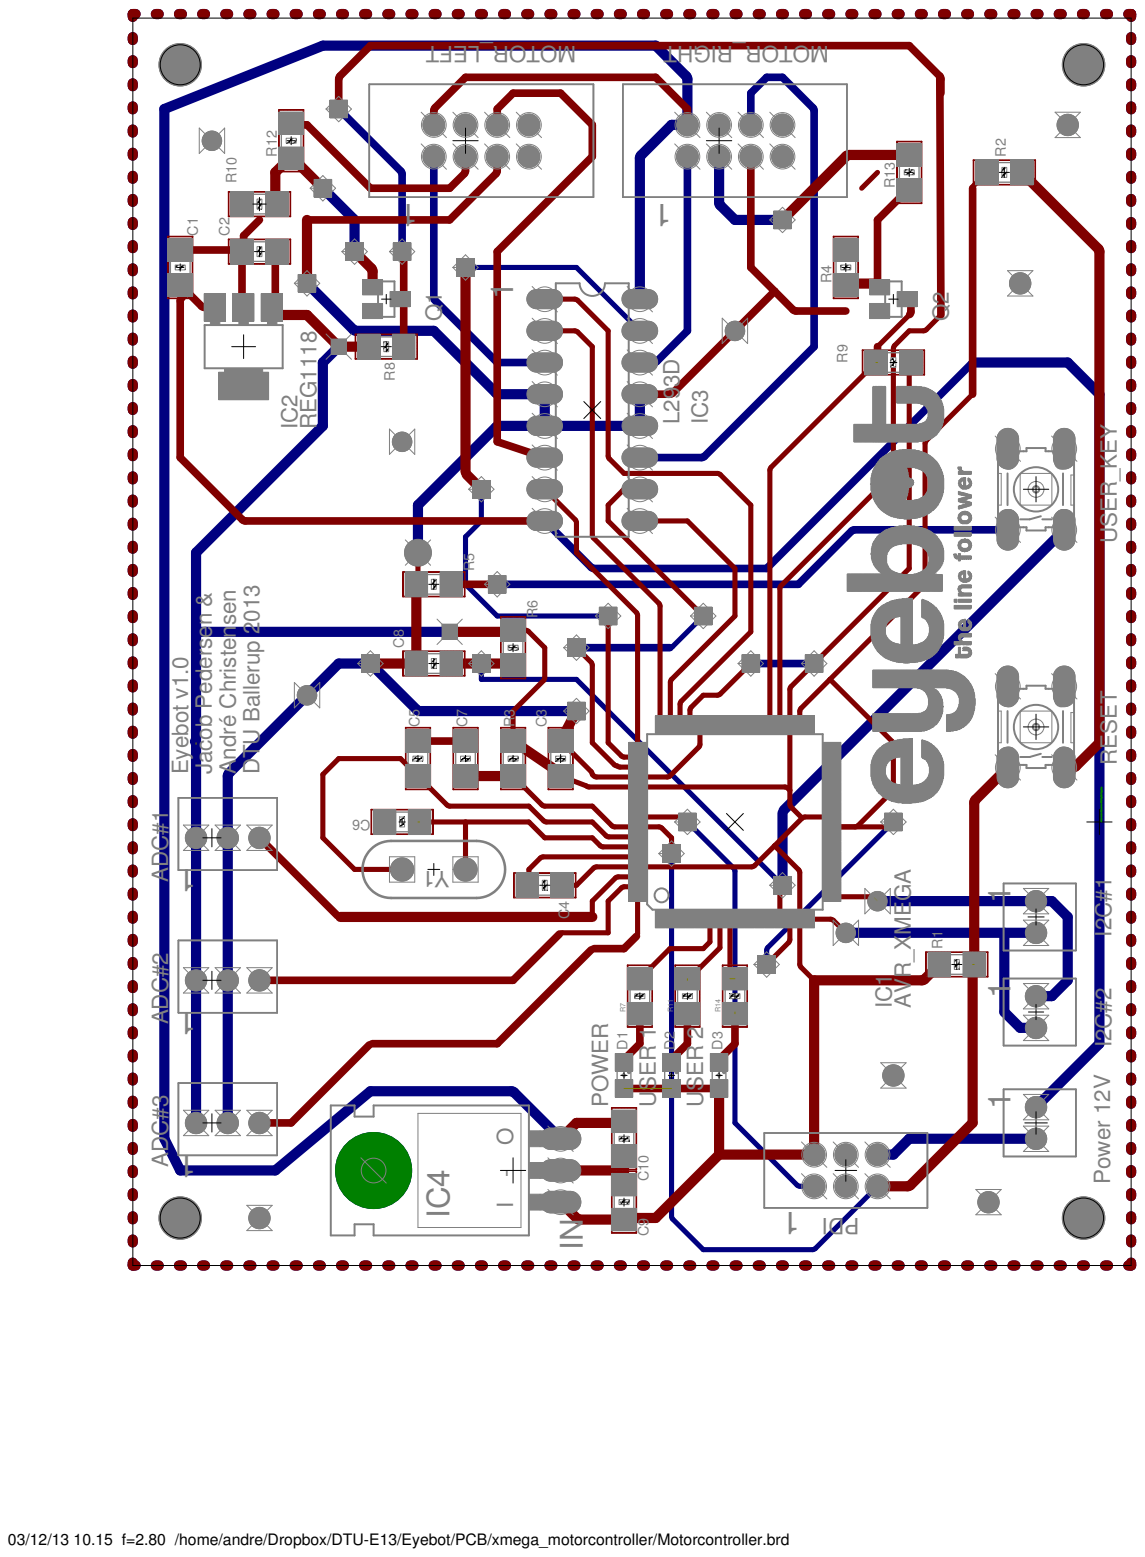
[picture p70: page 1]

03/12/13 10.15 f=2.80 /home/andre/Dropbox/DTU-E13/Eyebot/PCB/xmega_motorcontroller/Motorcontroller.brd
