bomstrong/eyebot_report/resources/PCB/PDF to print/Motorcontroller_pcb_1.pdf

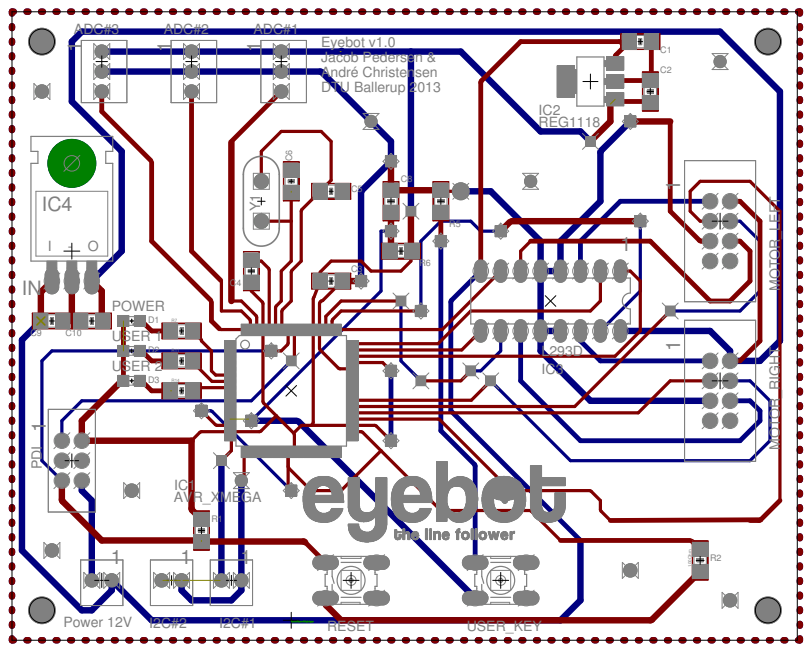
[picture p71: page 1]
