bomstrong/eyebot_report/resources/PCB/PDF to print/Motorcontroller_pcb_2.pdf

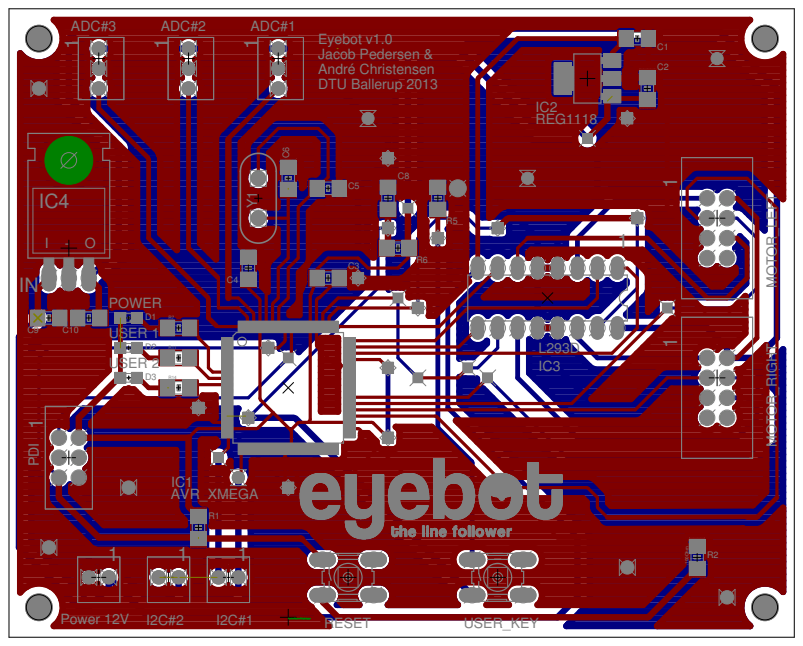
[picture p72: page 1]
