bomstrong/eyebot_report/resources/PCB/PDF to print/power_dist_pcb_1.pdf

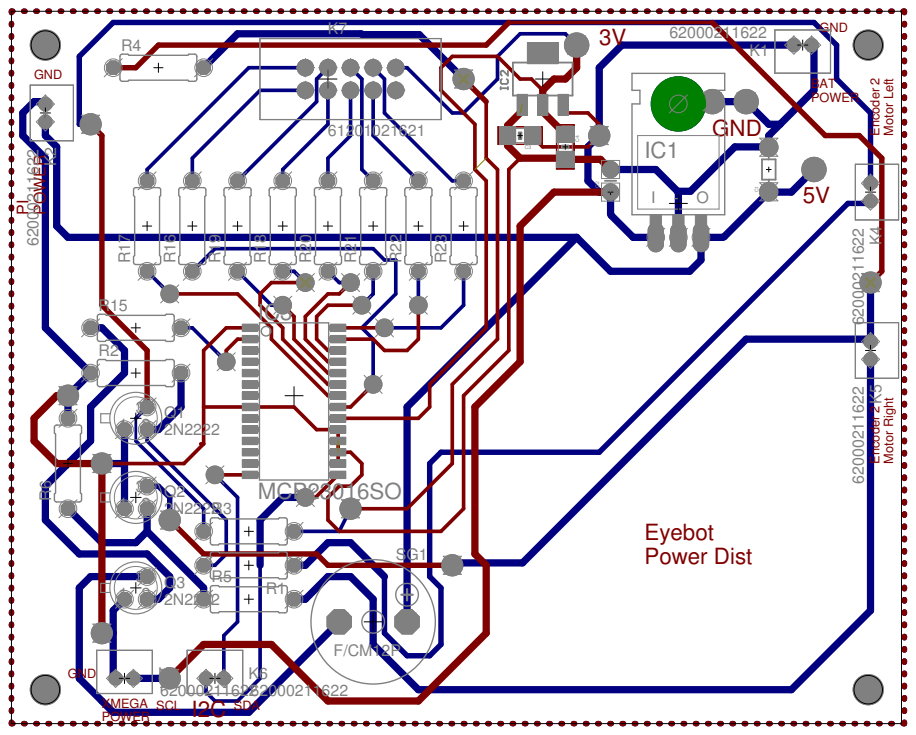
[picture p73: page 1]
