bomstrong/eyebot_report/resources/PCB/PDF to print/power_dist_pcb_2.pdf

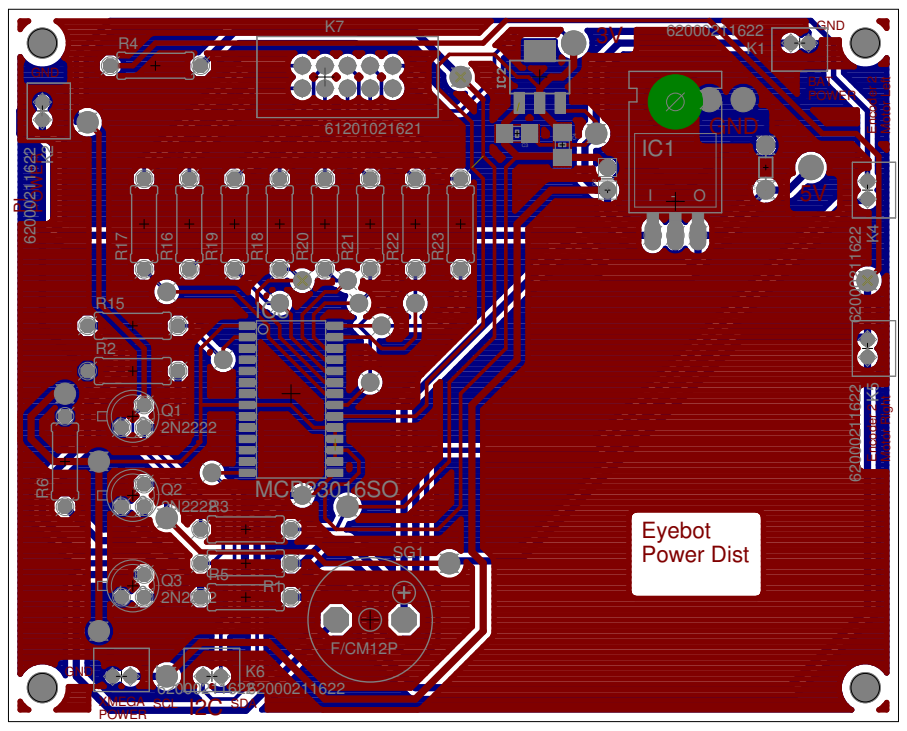
[picture p74: page 1]
