bomstrong/eyebot_report/resources/PCB/PDF to print/Power_dist_sch.pdf

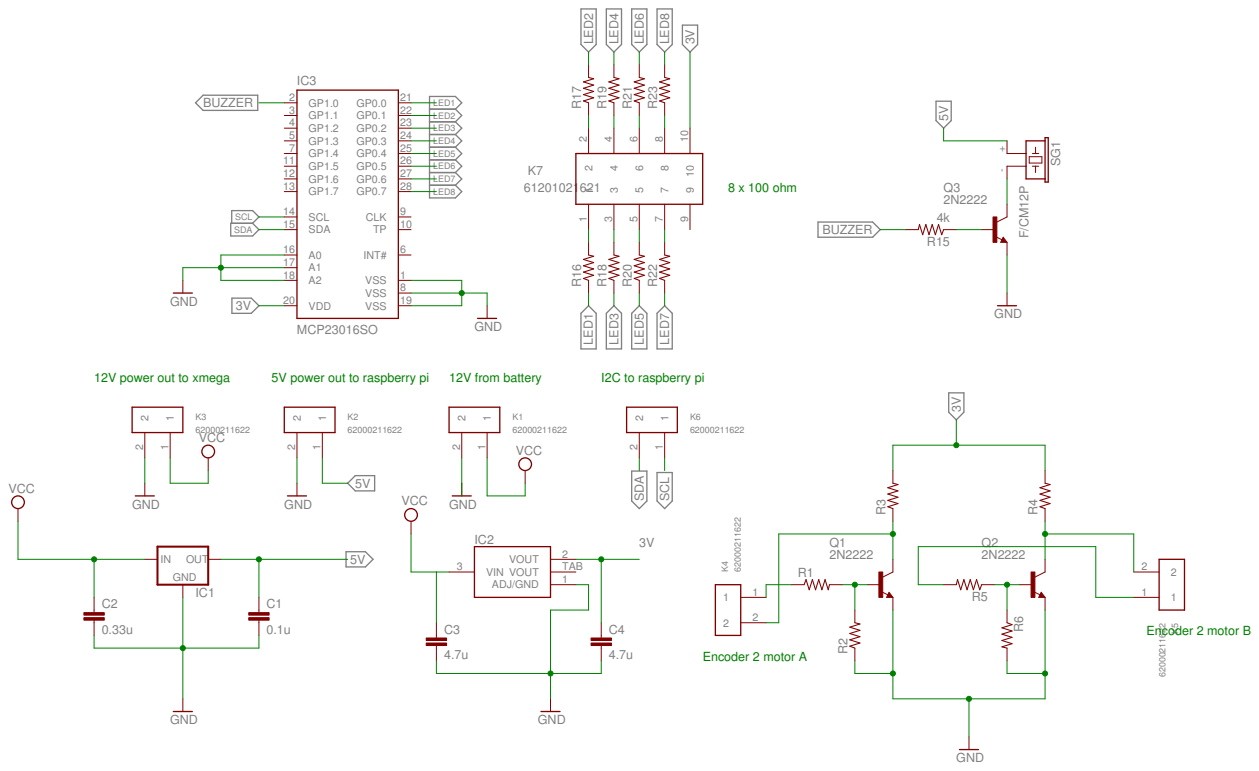
[picture p75: page 1]

17 | | 1
18
