bomstrong/eyebot_report/resources/PCB/Eyebot_powerdist/Eyebot_powerdist.brd

## EAGLE design resources/PCB/Eyebot_powerdist/Eyebot_powerdist.brd (2013-12-17)

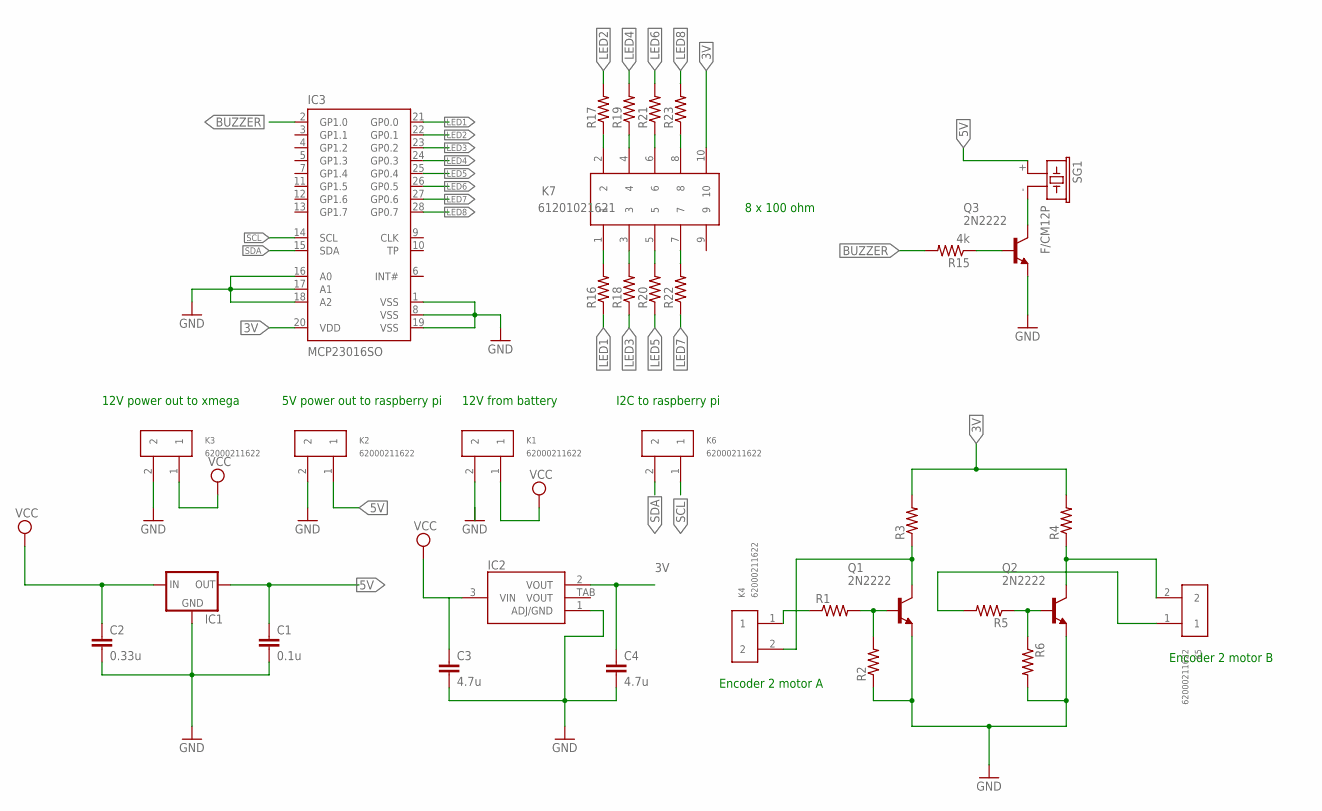
[picture p76: schematic Eyebot_powerdist.sch]

Parts:
C1: 0.1u; AXIAL-5MM
C2: 0.33u; CAP-PTH-SMALL
C3, C4: 4.7u; 1206
IC1: V_REG_78XX-TO-220; TO-220-ALT
IC2: LDO1117-SOT223; SOT223-3L
IC3: MCP23016SO; SO-28W
K1, K2, K3, K4, K5, K6: 62000211622
K7: 61201021621
Q1, Q2, Q3: 2N2222; TO18
R1, R2, R3, R4, R5, R6, R16, R17, R18, R19, R20, R21, R22, R23: R-US_0309/10; 0309/10
R15: 4k; 0309/10
SG1: F/CM12P

Connections:
3V: C4.1, IC2.2 (VOUT), IC3.20 (VDD), K7.10, R3.2, R4.2
5V: C1.P$1 (1), IC1.OUT, K2.1, SG1.+ (1)
BUZZER: IC3.2 (GP1.0), R15.2
GND: C1.P$2 (2), C2.2, C3.2, C4.2, IC1.GND, IC2.1 (ADJ/GND), IC3.1 (VSS), IC3.8 (VSS), IC3.16 (A0), IC3.17 (A1), IC3.18 (A2), IC3.19 (VSS), K1.2, K2.2, K3.2, Q1.1 (E), Q2.1 (E), Q3.1 (E), R2.1, R6.2
LED1: IC3.21 (GP0.0), R16.1
LED2: IC3.22 (GP0.1), R17.2
LED3: IC3.23 (GP0.2), R18.1
LED4: IC3.24 (GP0.3), R19.2
LED5: IC3.25 (GP0.4), R20.1
LED6: IC3.26 (GP0.5), R21.2
LED7: IC3.27 (GP0.6), R22.1
LED8: IC3.28 (GP0.7), R23.2
unnamed: Q1.2 (B), R1.2, R2.2
unnamed: K4.2, Q1.3 (C), R3.1
unnamed: K4.1, R1.1
unnamed: K7.2, R17.1
unnamed: Q2.2 (B), R5.1, R6.1
unnamed: K7.4, R19.1
unnamed: K5.1, R5.2
unnamed: K5.2, Q2.3 (C), R4.1
unnamed: K7.6, R21.1
unnamed: K7.8, R23.1
unnamed: K7.7, R22.2
unnamed: K7.5, R20.2
unnamed: K7.3, R18.2
unnamed: K7.1, R16.2
unnamed: Q3.2 (B), R15.1
unnamed: Q3.3 (C), SG1.- (2)
SCL: IC3.14 (SCL), K6.1
SDA: IC3.15 (SDA), K6.2
VCC: C2.1, C3.1, IC1.IN, IC2.3 (VIN), K1.1, K3.1

Notes on the sheet:
5V power out to raspberry pi
12V power out to xmega
12V from battery
Encoder 2 motor A
Encoder 2 motor B
I2C to raspberry pi
8 x 100 ohm

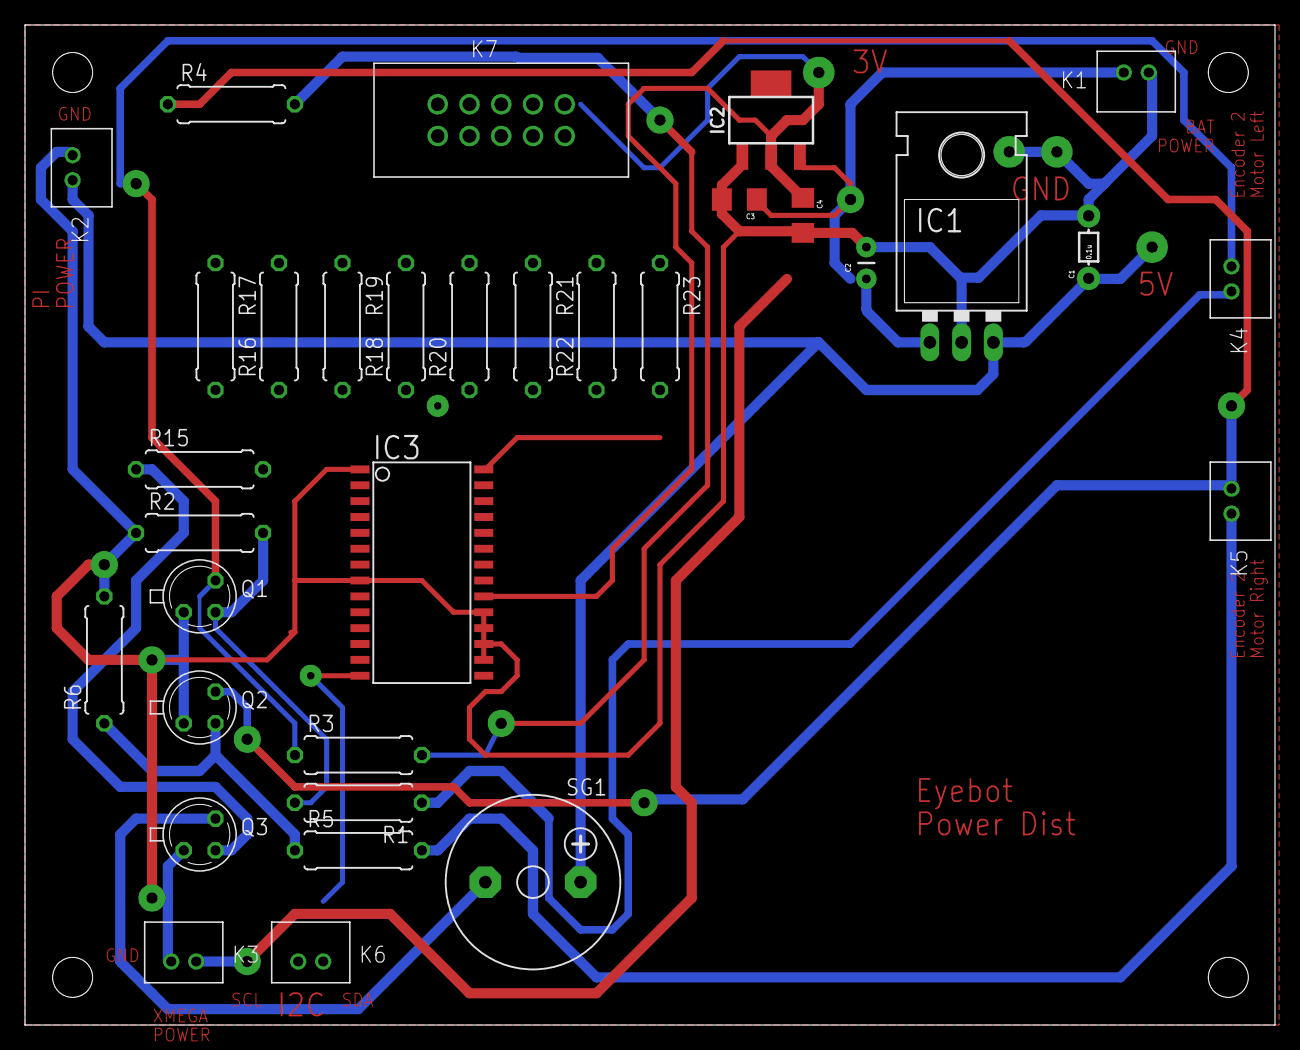
[picture p77: board Eyebot_powerdist.brd from above]

Board: 2 copper layers, 100.0 x 80.0 mm, 33 parts (0 on the bottom side), 31 nets.
