bomstrong/eyebot_report/resources/PCB/xmeag_motorcontroller_after_updates/Motorcontroller.brd

## EAGLE design resources/PCB/xmeag_motorcontroller_after_updates/Motorcontroller.brd (2013-12-15)

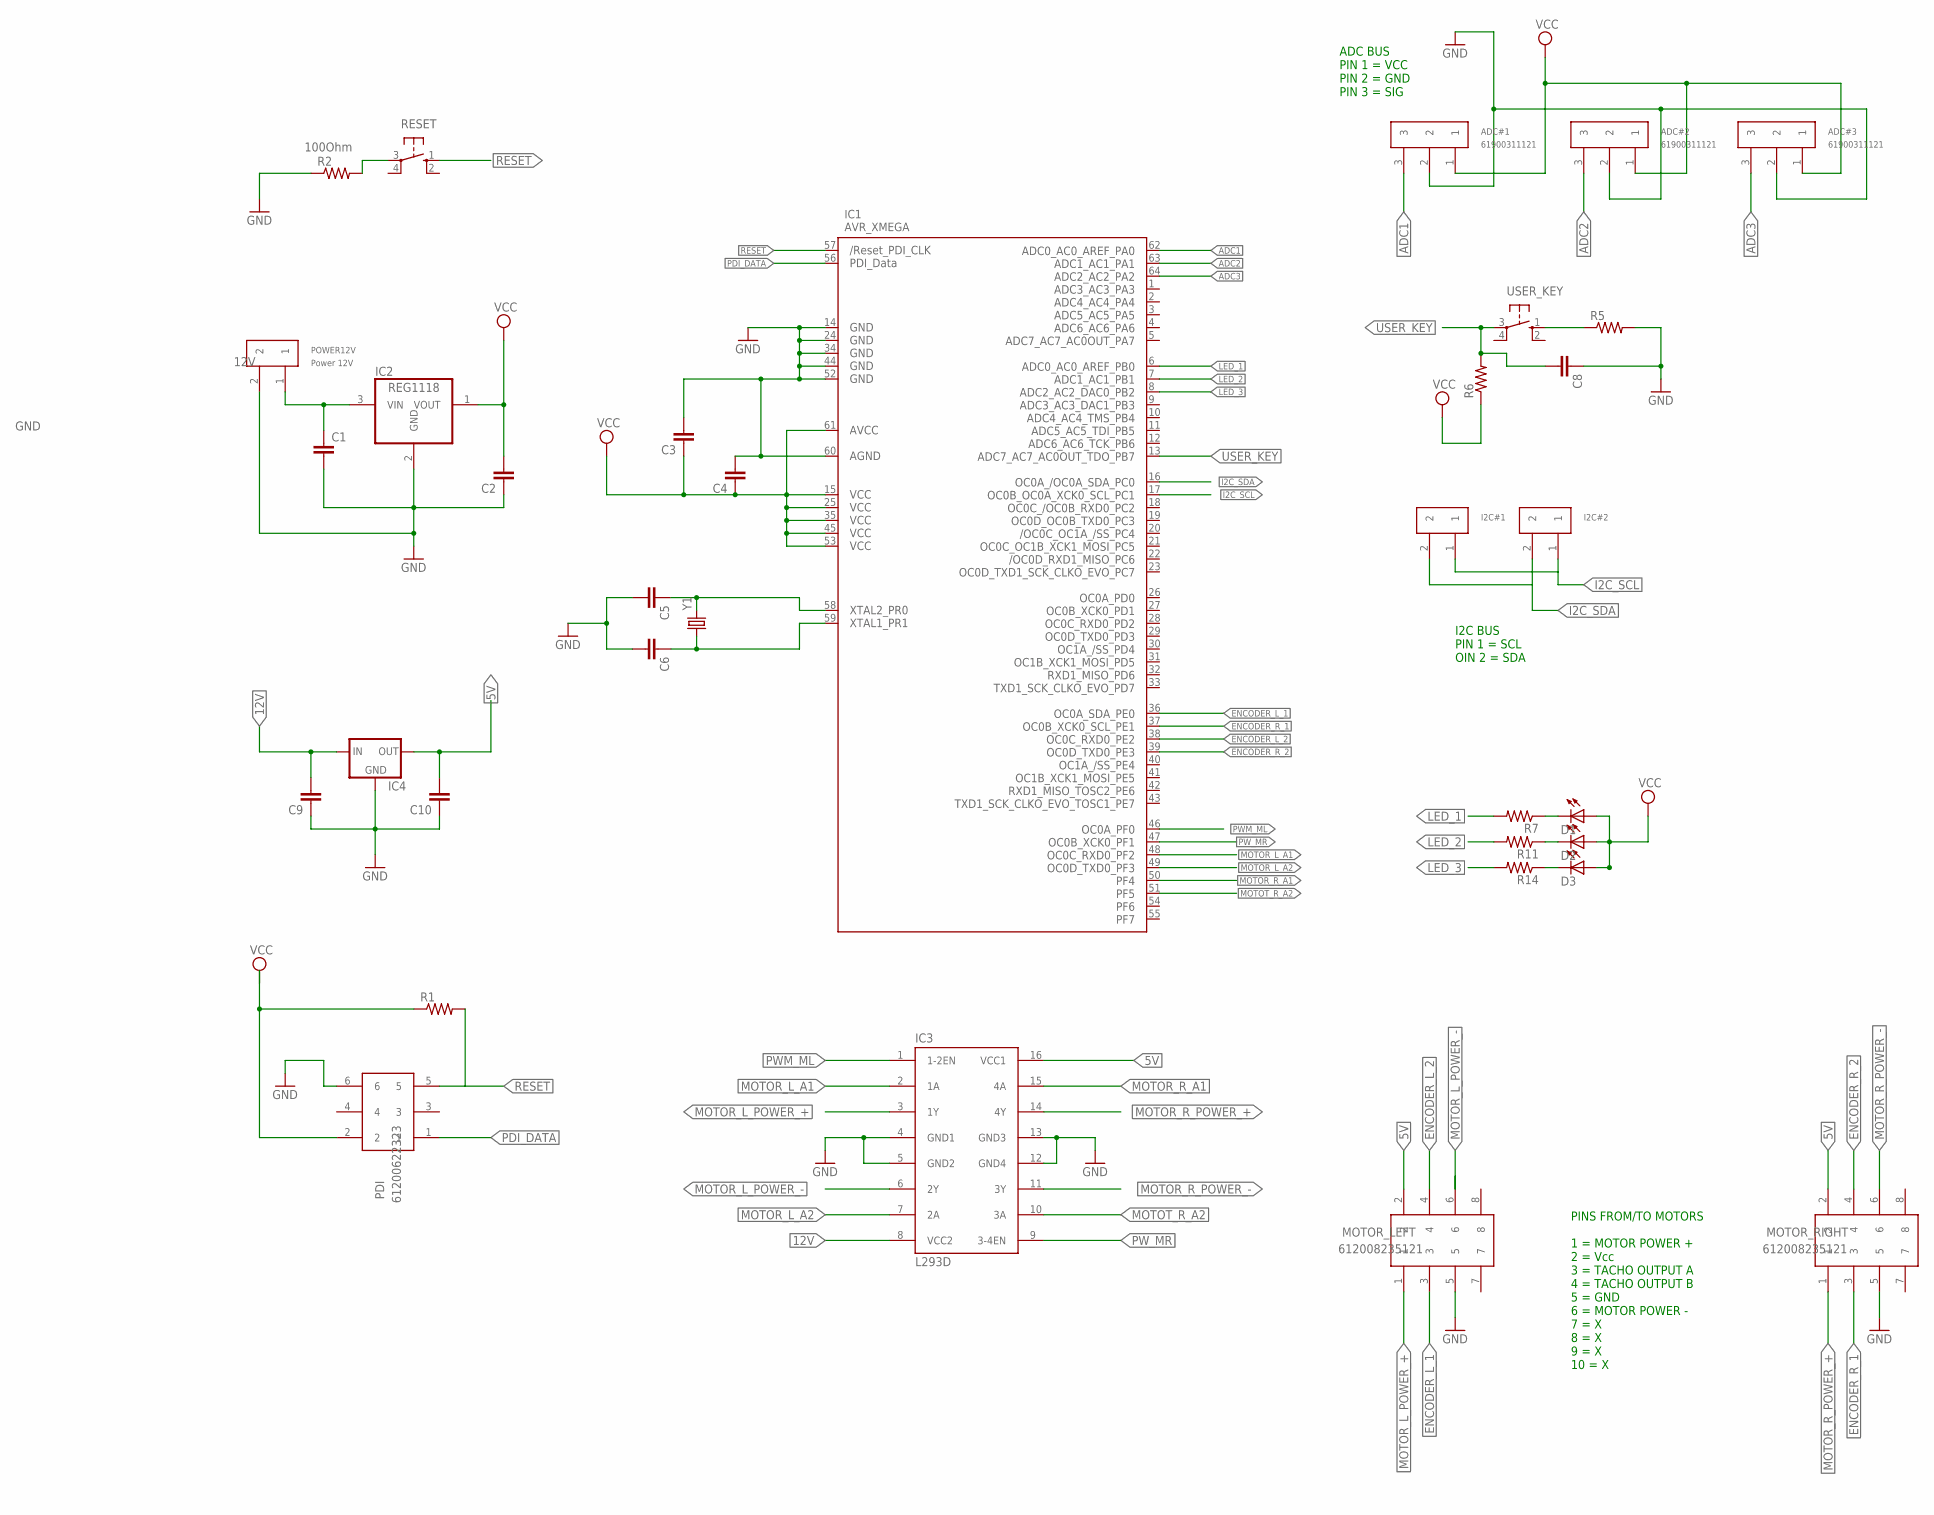
[picture p78: schematic Motorcontroller.sch]

Parts:
ADC#1, ADC#2, ADC#3: 61900311121
C1, C2, C3, C4, C5, C6, C8, C9, C10: CAP1206; 1206
D1, D2, D3: LEDSML0805; SML0805
I2C#1, I2C#2: 61900211121
IC1: AVR_XMEGA; TQFP64
IC2: REG1118; SOT223
IC3: L293D; DIL16
IC4: V_REG_78XX-TO-220; TO-220-ALT
MOTOR_LEFT: 612008235121
MOTOR_RIGHT: 612008235121
PDI: 61200622323
POWER12V: Power 12V; 61900211121
R1, R5, R6, R7, R11, R14: RESISTOR1206; 1206
R2: 100Ohm; 1206
RESET: 10-XX; B3F-10XX
USER_KEY: 10-XX; B3F-10XX
Y1: CRYSTALHC49US; HC49US

Connections:
5V: C10.2, IC3.16 (VCC1), IC4.OUT, MOTOR_LEFT.2, MOTOR_RIGHT.2
12V: C1.1, C9.2, IC2.3 (VIN), IC3.8 (VCC2), IC4.IN, POWER12V.1
ADC1: ADC#1.3, IC1.62 (PA0)
ADC2: ADC#2.3, IC1.63 (PA1)
ADC3: ADC#3.3, IC1.64 (PA2)
ENCODER_L_1: IC1.36 (PE0), MOTOR_LEFT.3
ENCODER_L_2: IC1.38 (PE2), MOTOR_LEFT.4
ENCODER_R_1: IC1.37 (PE1), MOTOR_RIGHT.3
ENCODER_R_2: IC1.39 (PE3), MOTOR_RIGHT.4
GND: ADC#1.2, ADC#2.2, ADC#3.2, C1.2, C2.1, C3.2, C4.2, C5.2, C6.2, C8.1, C9.1, C10.1, IC1.14 (GND1), IC1.24 (GND2), IC1.34 (GND3), IC1.44 (GND4), IC1.52 (GND5), IC1.60 (AGND), IC2.2 (GND), IC3.4 (GND1), IC3.5 (GND2), IC3.12 (GND4), IC3.13 (GND3), IC4.GND, MOTOR_LEFT.5, MOTOR_RIGHT.5, PDI.6, POWER12V.2, R2.1, R5.2
I2C_SCL: I2C#1.1, I2C#2.1, IC1.17 (PC1)
I2C_SDA: I2C#1.2, I2C#2.2, IC1.16 (PC0)
LED_1: IC1.6 (PB0), R7.2
LED_2: IC1.7 (PB1)
LED_3: IC1.8 (PB2)
MOTOR_L_A1: IC1.48 (PF2), IC3.2 (1A)
MOTOR_L_A2: IC1.49 (PF3), IC3.7 (2A)
MOTOR_L_POWER_+: IC3.3 (1Y), MOTOR_LEFT.1
MOTOR_L_POWER_-: IC3.6 (2Y), MOTOR_LEFT.6
MOTOR_R_A1: IC1.50 (PF4), IC3.15 (4A)
MOTOR_R_POWER_+: IC3.14 (4Y), MOTOR_RIGHT.1
MOTOR_R_POWER_-: IC3.11 (3Y), MOTOR_RIGHT.6
MOTOT_R_A2: IC1.51 (PF5), IC3.10 (3A)
unnamed: C5.1, IC1.58 (PR0), Y1.2
unnamed: C6.1, IC1.59 (PR1), Y1.1
unnamed: R2.2, RESET.3
unnamed: R5.1, USER_KEY.1 (S)
unnamed: D1.C, R7.1
unnamed: D2.C, R11.1
unnamed: D3.C, R14.1
PDI_DATA: IC1.56 (PDI_DATA), PDI.1
PWM_ML: IC1.46 (PF0), IC3.1 (1-2EN)
PW_MR: IC1.47 (PF1), IC3.9 (3-4EN)
RESET: IC1.57 (RESET), PDI.5, R1.2, RESET.1 (S)
USER_KEY: C8.2, IC1.13 (PB7), R6.2, USER_KEY.3
VCC: ADC#1.1, ADC#2.1, ADC#3.1, C2.2, C3.1, C4.1, D1.A, D2.A, D3.A, IC1.15 (VCC1), IC1.25 (VCC2), IC1.35 (VCC3), IC1.45 (VCC4), IC1.53 (VCC5), IC1.61 (AVCC), IC2.1 (VOUT), PDI.2, R1.1, R6.1

Notes on the sheet:
I2C BUS PIN 1 = SCL OIN 2 = SDA
ADC BUS PIN 1 = VCC PIN 2 = GND PIN 3 = SIG
PINS FROM/TO MOTORS 1 = MOTOR POWER + 2 = Vcc 3 = TACHO OUTPUT A 4 = TACHO OUTPUT B 5 = GND 6 = MOTOR POWER - 7 = X 8 = X 9 = X 10 = X

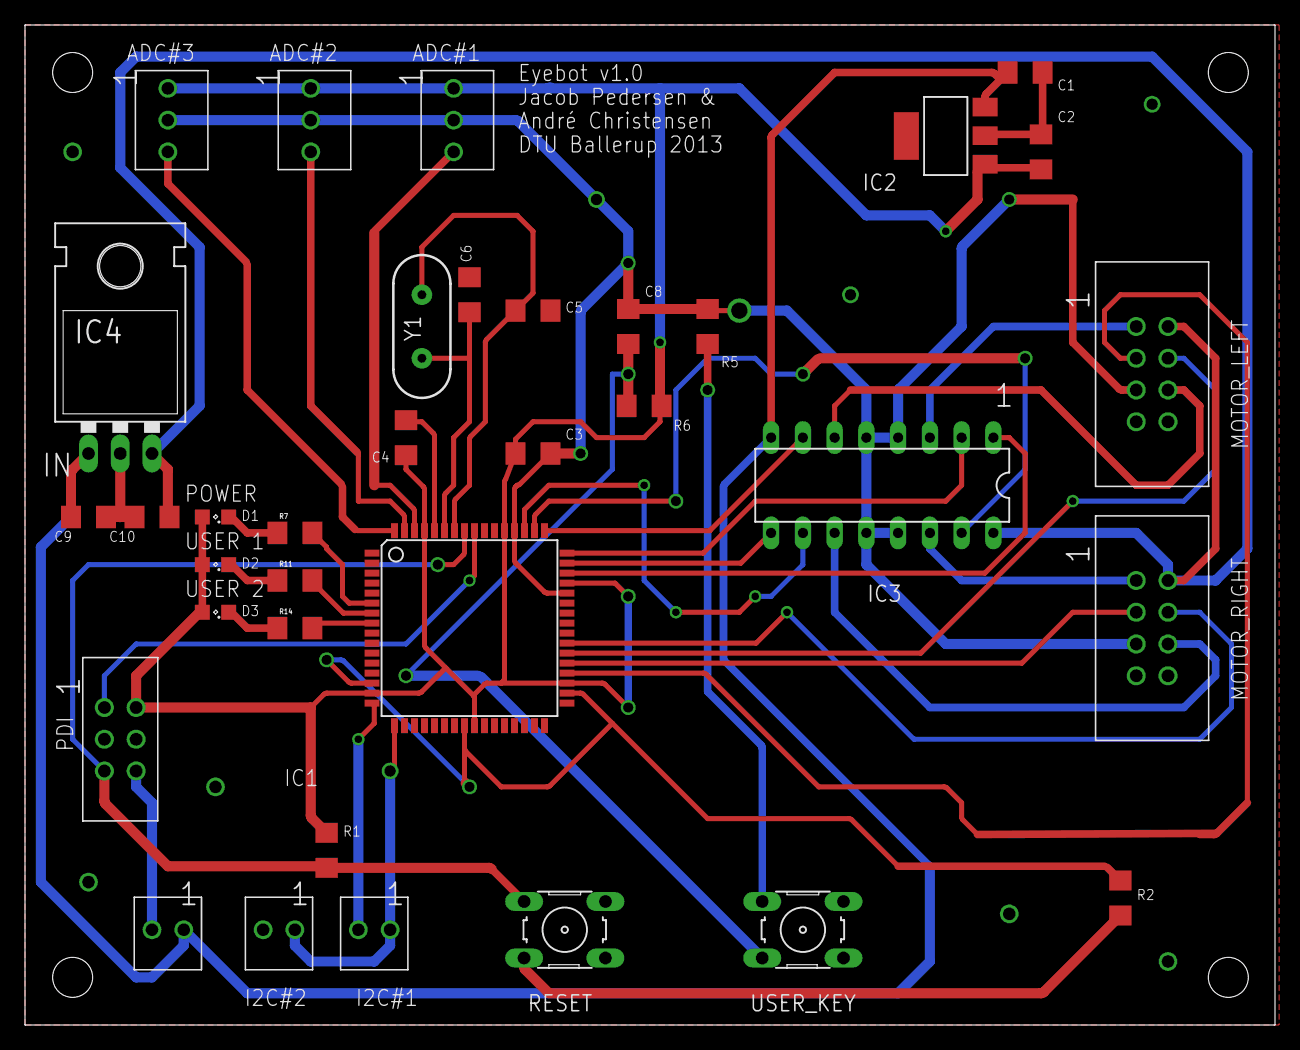
[picture p79: board Motorcontroller.brd from above]

Board: 2 copper layers, 100.0 x 80.0 mm, 36 parts (0 on the bottom side), 34 nets.

Other parts of the board:
U$3: LOGO2
