bomstrong/eyebot_report/resources/PCB/H-Bridge/H_bridge.brd

## EAGLE design resources/PCB/H-Bridge/H_bridge.brd (2013-12-14)

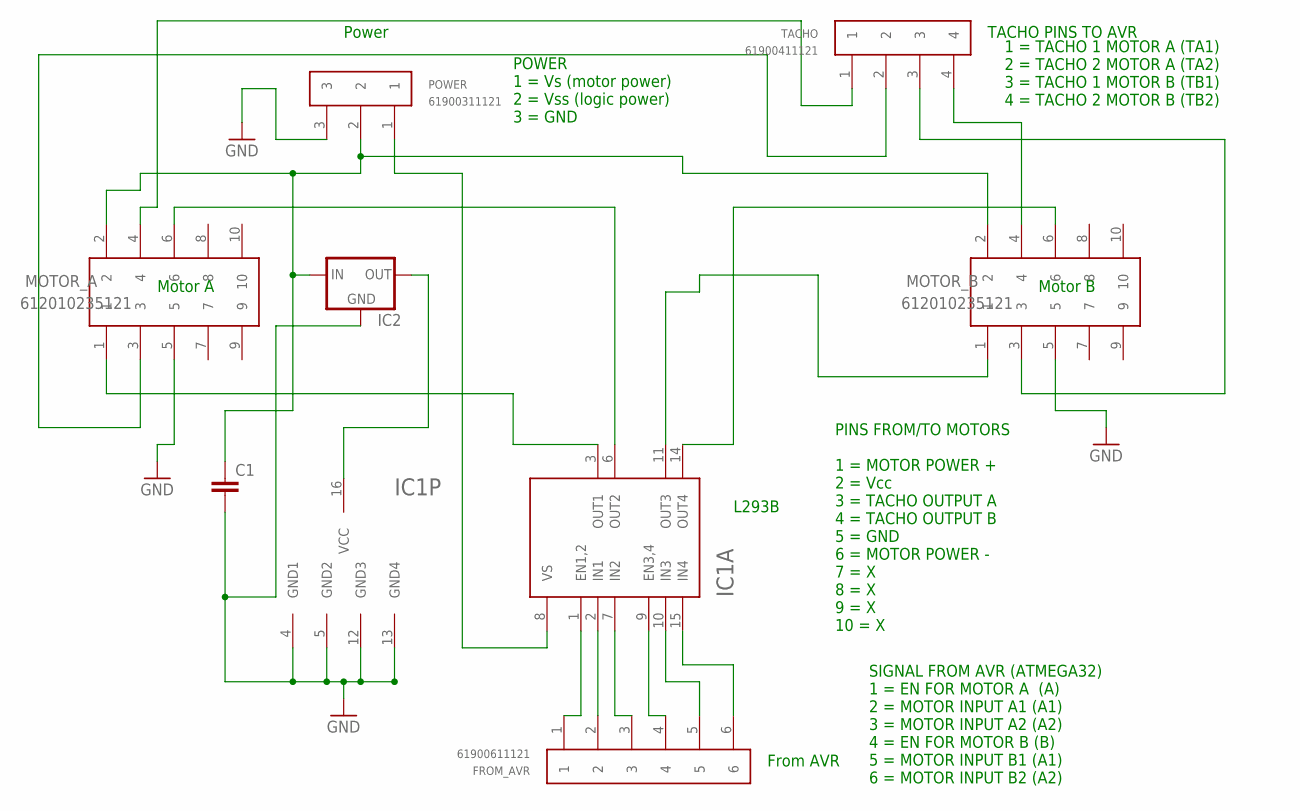
[picture p80: schematic H_bridge.sch]

Parts:
C1: C7.5/5; C7.5B5
FROM_AVR: 61900611121
IC1: L293D; DIP16
IC2: V_REG_78XX-TO-220; TO-220-ALT
MOTOR_A: 612010235121
MOTOR_B: 612010235121
POWER: 61900311121
TACHO: 61900411121

Connections:
GND: C1.2, IC1.4 (GND1), IC1.5 (GND2), IC1.12 (GND3), IC1.13 (GND4), IC2.GND, MOTOR_A.5, MOTOR_B.5, POWER.3
unnamed: IC1.3 (OUT1), MOTOR_A.1
unnamed: IC1.6 (OUT2), MOTOR_A.6
unnamed: IC1.11 (OUT3), MOTOR_B.1
unnamed: IC1.14 (OUT4), MOTOR_B.6
unnamed: MOTOR_B.3, TACHO.3
unnamed: IC1.16 (VCC), IC2.OUT
unnamed: C1.1, IC2.IN, MOTOR_A.2, MOTOR_B.2, POWER.2
unnamed: FROM_AVR.1, IC1.1 (EN1,2)
unnamed: FROM_AVR.2, IC1.2 (IN1)
unnamed: FROM_AVR.3, IC1.7 (IN2)
unnamed: FROM_AVR.4, IC1.9 (EN3,4)
unnamed: FROM_AVR.5, IC1.10 (IN3)
unnamed: FROM_AVR.6, IC1.15 (IN4)
unnamed: MOTOR_A.4, TACHO.1
unnamed: MOTOR_A.3, TACHO.2
unnamed: MOTOR_B.4, TACHO.4
unnamed: IC1.8 (VS), POWER.1

Notes on the sheet:
Motor A
Motor B
TACHO PINS TO AVR
Power
From AVR
L293B
POWER 1 = Vs (motor power) 2 = Vss (logic power) 3 = GND
SIGNAL FROM AVR (ATMEGA32) 1 = EN FOR MOTOR A (A) 2 = MOTOR INPUT A1 (A1) 3 = MOTOR INPUT A2 (A2) 4 = EN FOR MOTOR B (B) 5 = MOTOR INPUT B1 (A1) 6 = MOTOR INPUT B2 (A2)
1 = TACHO 1 MOTOR A (TA1) 2 = TACHO 2 MOTOR A (TA2) 3 = TACHO 1 MOTOR B (TB1) 4 = TACHO 2 MOTOR B (TB2)
PINS FROM/TO MOTORS 1 = MOTOR POWER + 2 = Vcc 3 = TACHO OUTPUT A 4 = TACHO OUTPUT B 5 = GND 6 = MOTOR POWER - 7 = X 8 = X 9 = X 10 = X

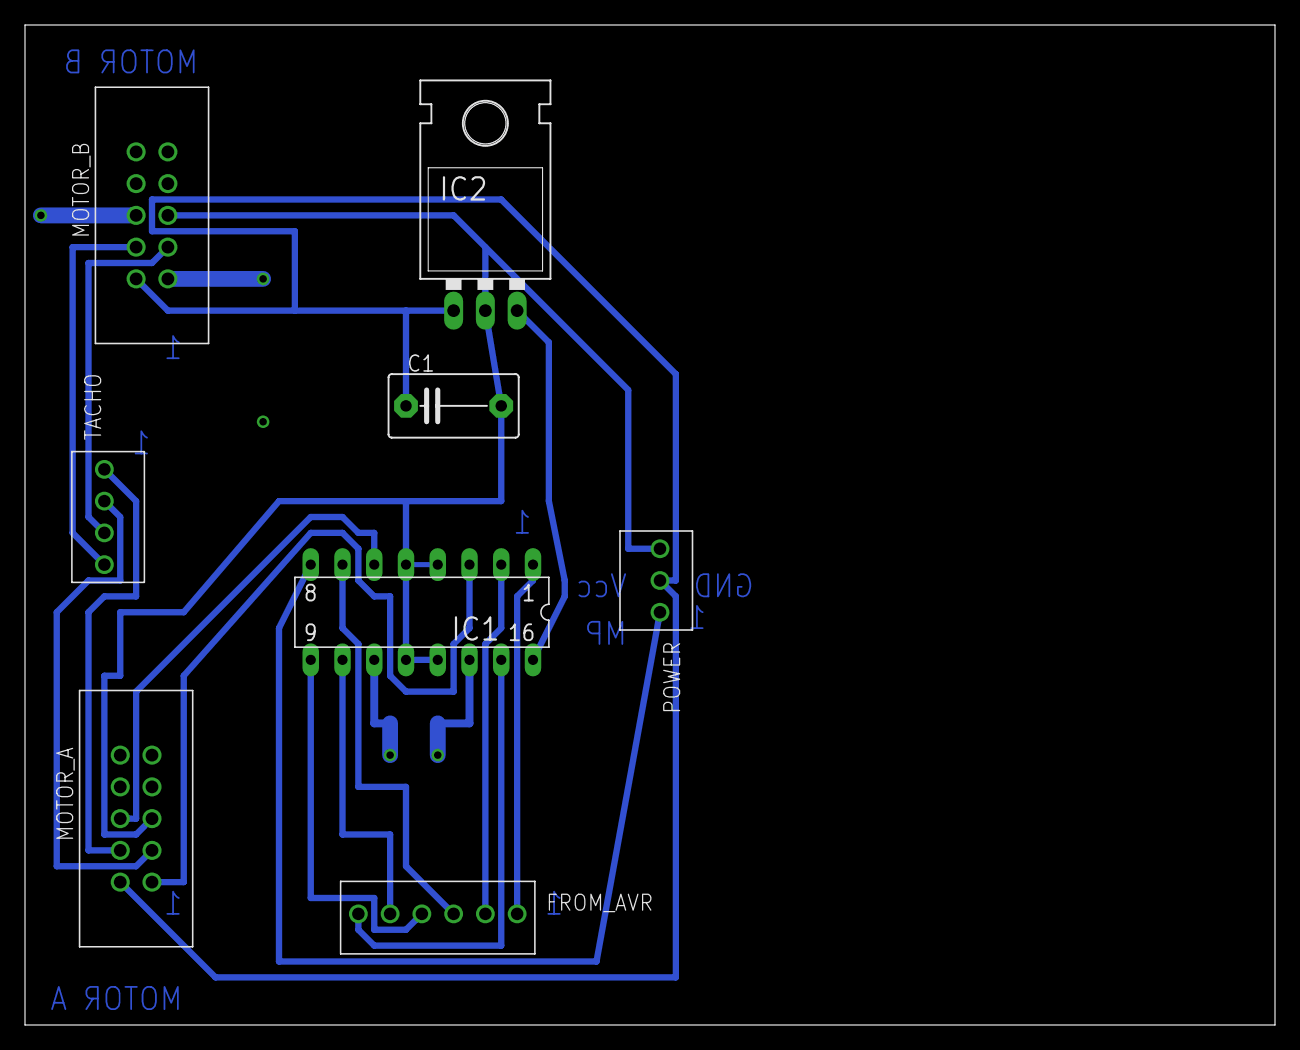
[picture p81: board H_bridge.brd from above]

Board: 2 copper layers, 100.0 x 80.0 mm, 8 parts (0 on the bottom side), 18 nets.
