bomstrong/eyebot_report/resources/PCB/Atmega32/Atmega32_test.brd

## EAGLE design resources/PCB/Atmega32/Atmega32_test.brd (2013-12-14)

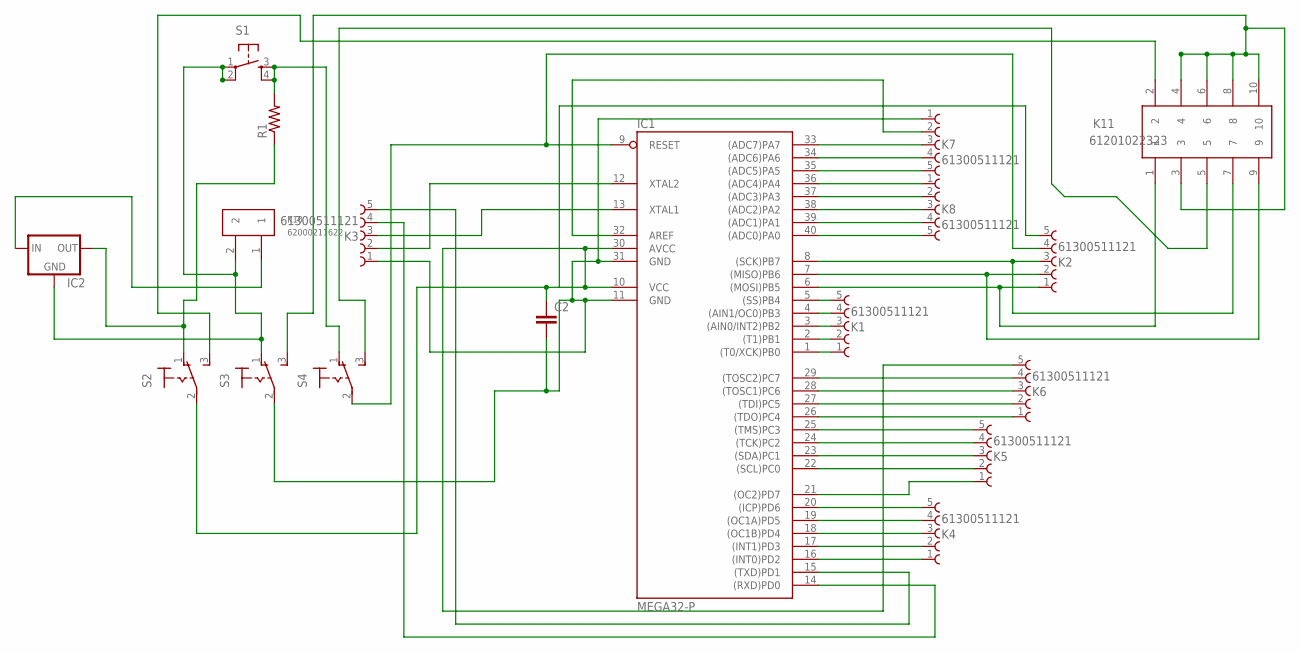
[picture p82: schematic Atmega32_test.sch]

Parts:
C2: C10/6; C10B6
IC1: MEGA32-P; DIL40
IC2: V_REG_78XX-TO-220; TO-220-ALT
K1, K2, K3, K4, K5, K6, K7, K8: 61300511121
K10: 62000211622
K11: 61201022323
R1: 10KOHM1/6W5%(PTH)KIT; AXIAL-0.3-KIT
S1: TAC_SWITCHPTH; TACTILE-PTH
S2, S3, S4: 320-916

Connections:
unnamed: IC1.12 (XTAL2), K3.2
unnamed: IC1.26 ((TDO)PC4), K6.1
unnamed: IC1.1 ((T0/XCK)PB0), K1.1
unnamed: IC1.5 ((SS)PB4), K1.5
unnamed: IC1.3 ((AIN0/INT2)PB2), K1.3
unnamed: IC1.4 ((AIN1/OC0)PB3), K1.4
unnamed: IC1.2 ((T1)PB1), K1.2
unnamed: IC1.6 ((MOSI)PB5), K2.1, K11.1
unnamed: IC1.7 ((MISO)PB6), K2.2, K11.9
unnamed: IC1.8 ((SCK)PB7), K2.3, K11.7
unnamed: IC1.39 ((ADC1)PA1), K8.4
unnamed: C2.2, IC1.11 (GND), IC1.31 (GND), K3.1, K7.1, S3.2
unnamed: IC1.9 (RESET), K2.4, S4.2
unnamed: K11.2, S2.3 (S)
unnamed: IC1.14 ((RXD)PD0), K3.4
unnamed: IC2.IN, K10.1
unnamed: IC1.17 ((INT1)PD3), K4.2
unnamed: IC1.16 ((INT0)PD2), K4.1
unnamed: IC1.18 ((OC1B)PD4), K4.3
unnamed: IC1.19 ((OC1A)PD5), K4.4
unnamed: IC1.20 ((ICP)PD6), K4.5
unnamed: IC1.21 ((OC2)PD7), K5.1
unnamed: IC1.22 ((SCL)PC0), K5.2
unnamed: IC1.23 ((SDA)PC1), K5.3
unnamed: IC1.24 ((TCK)PC2), K5.4
unnamed: IC1.25 ((TMS)PC3), K5.5
unnamed: IC1.27 ((TDI)PC5), K6.2
unnamed: IC1.28 ((TOSC1)PC6), K6.3
unnamed: IC1.29 ((TOSC2)PC7), K6.4
unnamed: IC1.13 (XTAL1), K3.3
unnamed: IC1.32 (AREF), K7.2
unnamed: IC1.36 ((ADC4)PA4), K8.1
unnamed: IC1.33 ((ADC7)PA7), K7.3
unnamed: IC1.34 ((ADC6)PA6), K7.4
unnamed: IC1.35 ((ADC5)PA5), K7.5
unnamed: IC1.37 ((ADC3)PA3), K8.2
unnamed: IC1.38 ((ADC2)PA2), K8.3
unnamed: IC1.40 ((ADC0)PA0), K8.5
unnamed: IC2.OUT, R1.P$1 (1), S2.1 (O)
unnamed: R1.P$2 (2), S1.3, S1.4, S4.1 (O)
unnamed: K11.3, K11.4, K11.6, K11.8, K11.10, S3.3 (S)
unnamed: IC2.GND, K10.2, S1.1, S1.2, S3.1 (O)
unnamed: K11.5, S4.3 (S)
unnamed: IC1.15 ((TXD)PD1), K3.5
unnamed: C2.1, IC1.10 (VCC), IC1.30 (AVCC), K2.5, K6.5, S2.2

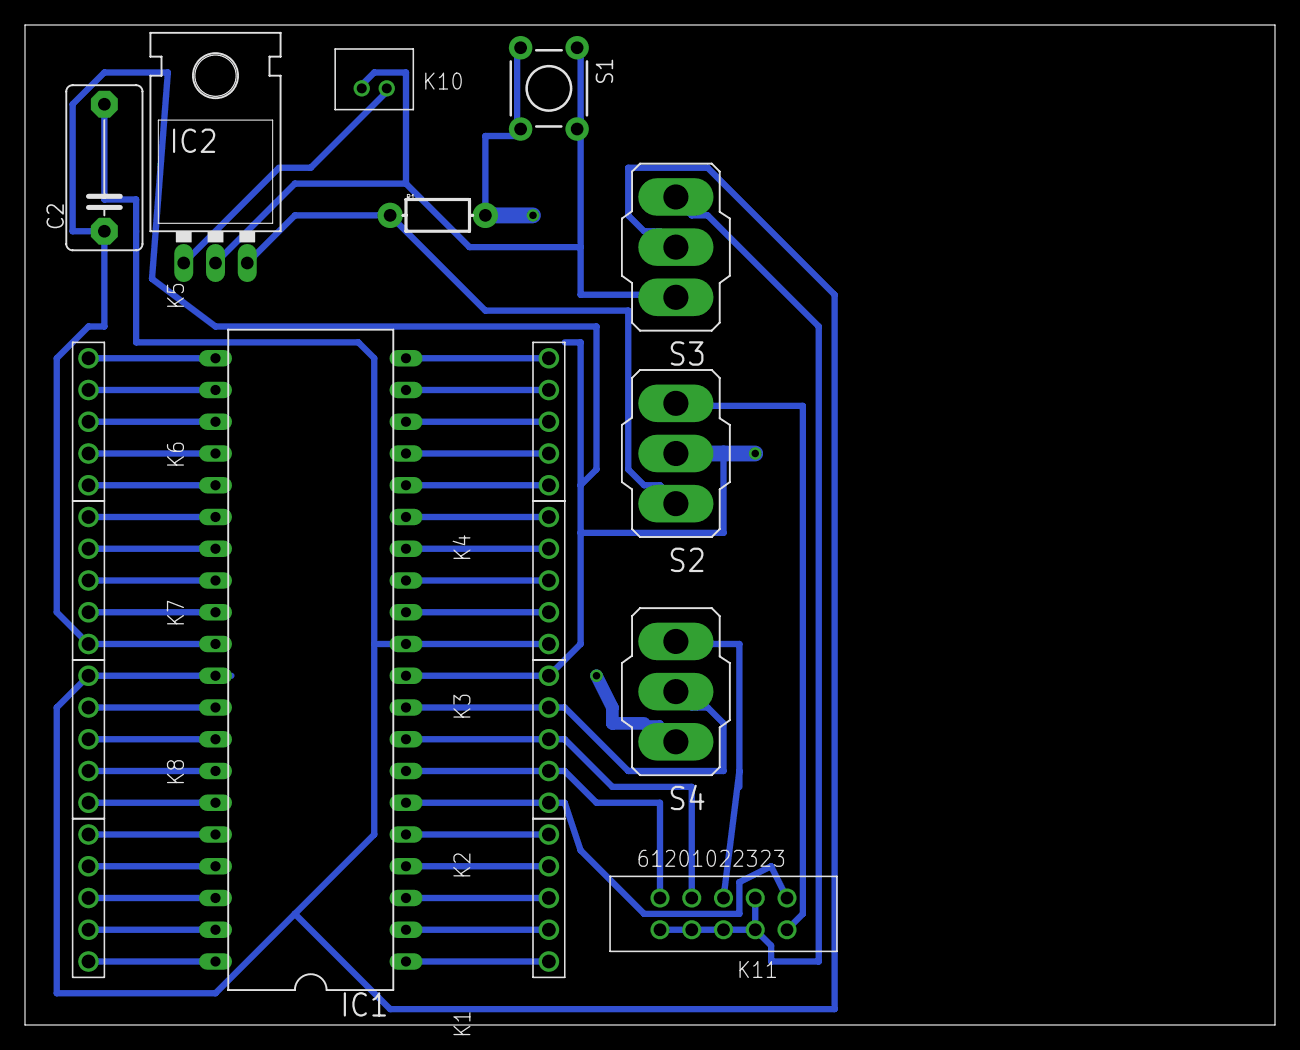
[picture p83: board Atmega32_test.brd from above]

Board: 2 copper layers, 100.0 x 80.0 mm, 18 parts (0 on the bottom side), 45 nets.
