bomstrong/eyebot_report/(commit log)

2013-12-14 added pcb to resources
2013-12-14 old pcbs added to resources
    [Atmega32_test.brd, Atmega32_test.sch, Eyebot_powerdist.brd, Eyebot_powerdist.sch, H_bridge.brd, H_bridge.sch]
2013-12-14 xmega pcb updates added to resources
    [Motorcontroller.brd, Motorcontroller.sch]
2013-12-14 Chapter 2 - camera.
2013-12-15 IR sensor chapter + key words in i2c chapter
    [Motorcontroller.brd, Motorcontroller.sch]
2013-12-15 i2c chapter
    [Motorcontroller.sch]
2013-12-16 from bom
2013-12-17 Simulink files
    [Eyebot_powerdist.brd, Eyebot_powerdist.sch]
2013-12-20 lidt rettelser her og der
