bomstrong/eyebot_report/(notices)

Notices in the files:
parts and their libraries:
SparkFun-FreqCtrl: Licensing: CC v3.0 Share-Alike You are welcome to use this library for commercial purposes.
Wuerth_Elektronik_eiCan_05_Box_Header_ID: Copyright: Würth Elektronik
